rafael-at97/WMRA-UnB/README.md

# WMRA-UnB
Analysis and control of a Wheelchair Mounter Robotic Arm for a graduation thesis project in the University of Brasilia

Some code in here is supposed to be run using robopy - The python version for the Robotics Toolbox create by Peter Corke for Matlab
