rafael-at97/WMRA-UnB/hardware/CAD/Modelo3D/Note.txt

This is the model of the manipulator using the software SolidWords, the main Assembly is in the top page and sub-assemblies/parts are
organized in sub-directories.
