rafael-at97/WMRA-UnB/docs/secoes/simbolos.tex

%TCIDATA{LaTeXparent=0,0,these.tex}

%\chapter*{\setfontarial\mdseries LISTA DE SÍMBOLOS} % se usar ft1unb.sty, descomente esta linha

\chapter*{LISTA DE SÍMBOLOS}

% se usar ft2unb.sty, descomente esta linha

\subsection*{Símbolos Latinos}

\begin{tabular}{p{0.1\textwidth}p{0.63\textwidth}>{\PreserveBacklash\raggedleft}p{0.15\textwidth}}
$e$             & Força contra-eletromotriz     & {[}V{]}           \tabularnewline    
$I$             & Corrente elétrica             & {[}A{]}           \tabularnewline 
$\textbf{I}$    & Tensor de inércia             & 3x3{[}kg.m$^2${]} \tabularnewline
$\mathcal{I}$   & Momento de inércia angular    & {[}kg.m$^2${]}    \tabularnewline
$\textbf{J}$    & Matriz Jacobiana              &                   \tabularnewline
$M$             & Torque/Momento de de Força    & {[}N.m{]}         \tabularnewline
$\textbf{q}$    & Vetor das variáveis de juntas &                   \tabularnewline
$\textbf{r}$    & Vetor de posição              & 3x1{[}m{]}        \tabularnewline
$t$             & Tempo                         & {[}s{]}           \tabularnewline
$\textbf{T}$    & Matriz de transformação       &                   \tabularnewline
$v$             & Velocidade linear             & {[}m/s{]}         \tabularnewline
$\textbf{v}$    & Vetor de velocidades lineares &                   \tabularnewline
$V$             & Tensão elétrica               & {[}V{]}           \tabularnewline
$Z$             & Impedância elétrica           & {[}$\Omega${]}    \tabularnewline 
\end{tabular}

\subsection*{Símbolos Gregos}

\begin{tabular}{p{0.1\textwidth}p{0.63\textwidth}>{\PreserveBacklash\raggedleft}p{0.15\textwidth}}
$\alpha$            & Ângulo, constante                 & {[}rad{]}     \tabularnewline
$\delta$            & Variação                          &               \tabularnewline
$\theta$            & Ângulo, variável                  & {[}rad{]}     \tabularnewline
\boldmath{$\Theta$} & Vetor de ângulos                  &               \tabularnewline
$\tau$              & Constante de tempo                & {[}s{]}       \tabularnewline
$\omega$            & Velocidade angular                & {[}rad/s{]}   \tabularnewline
\boldmath{$\omega$} & Vetor de velocidades angulares    &               \tabularnewline
\boldmath{$\nu$}    & Vetor de velocidades              &               \tabularnewline
\end{tabular}

\subsection*{Grupos Adimensionais}

\begin{tabular}{p{0.1\textwidth}p{0.8\textwidth}}
i, k    &   Contador    \tabularnewline
\end{tabular}

\subsection*{Subscritos}

\begin{tabular}{p{0.1\textwidth}p{0.8\textwidth}}
$Th$    & Equivalente de Thévenin   \tabularnewline
%$ref$  & referência \tabularnewline
%$fer$  & ferramenta \tabularnewline
%$sis$  & sistema \tabularnewline
%$des$  & desejado\tabularnewline
\end{tabular}

\subsection*{Sobrescritos}

\begin{tabular}{p{0.1\textwidth}p{0.8\textwidth}}
$\hat{}$    & Vetor unitário    \tabularnewline
$\cdot$     & Variação temporal \tabularnewline
%$-$  & Valor médio \tabularnewline
\end{tabular}

\subsection*{Siglas}

\begin{tabular}{p{0.1\textwidth}p{0.8\textwidth}}
ABS     & \textit{Acrylonitrile Butadiene Styrene} - Acrilonitrila Butadieno Estireno           \tabularnewline   
AC      & \textit{Alternating Current} - Corrente Alternada                                     \tabularnewline
ADC     & \textit{Analog-to-Digital Converter} - Conversor Analógico-Digital                    \tabularnewline
ADL     & \textit{Activities of Daily Living} - Atividades Diárias Básicas                      \tabularnewline
CI      & Circuito Integrado                                                                    \tabularnewline
CMRR    & \textit{Common-Mode Rejection Ratio} - Taxa de Rejeição de Modo Comum                 \tabularnewline
CTR     & \textit{Current Transfer Ratio} - Taxa de Transmissão de Corrente                     \tabularnewline
DC      & \textit{Direct Current} - Corrente Contínua                                           \tabularnewline
DH      & Denavit-Hartenberg                                                                    \tabularnewline
LED     & \textit{Light Emitting Diode} - Diodo Emissor de Luz                                  \tabularnewline
MCU     & \textit{Microcontroller Unit} - Unidade microcontroladora                             \tabularnewline
ONU     & Organização das Nações Unidas                                                         \tabularnewline
PIC     & \textit{Peripheral Interface Controller} - Controlador de Interface Periférica        \tabularnewline
PID     & Proporcional Integral Derivativo                                                      \tabularnewline
PLA     & Poliácido láctico                                                                     \tabularnewline
PPR     & Pulsos por revolução                                                                  \tabularnewline
PVC     & \textit{Polyvinyl chloride} - Policloreto de vinila                                   \tabularnewline
PWM     & \textit{Pulse Width Modulation} - Modulação por largura de pulso                      \tabularnewline
TA      & Tecnologia Assistiva                                                                  \tabularnewline
UnB     & Universidade de Brasília                                                              \tabularnewline
WMRA    & \textit{Weelchair Mounted Robotic Arm} - Braço Robótico Montado em Cadeira de Rodas   \tabularnewline
%PCI  & \textit{Peripheral Component Interconnect}\tabularnewline
%CPU & Unidade Central de Processamento - \textit{Central Processing Unit} \tabularnewline
%AO & Saída Analógica - \textit{Analog Out}\tabularnewline
%DO & Saída Digital - \textit{Digital Out}\tabularnewline
%CS & Seletor de \textit{Chip - Chip Select}\tabularnewline
%SC & Sem Conexão\tabularnewline
%P.I. & Placa de Interface\tabularnewline
%ICW & \textit{Initialization Command Words}\tabularnewline
%OCW & \textit{Operational Control Word}\tabularnewline
\end{tabular}
