rafael-at97/WMRA-UnB/docs/revisoes/relatorio_revisoes.odt

Revisões Trabalho de Graduação

Rafael Torres – 15/0145365

- Resumo e abstract reescritos
- Símbolos alterados, negritos indicam matrizes (1xn, nx1, nxn ou nxm).
- Inserida ficha catalográfica
- Inseridos agradecimentos
- Inserida dedicatória

Introdução

- chapas de alumínio conformado → chapas de alumínio cortadas e dobradas
- primeira junta → quadril
- Termos guinada, rolagem e arfagem escritos na língua inglesa, Yaw, Pitch e roll
- punho → pulso
- “relaçãos” → reduções
- Incluída citação na tabela 1.1
- Incluídos tipos dos motores na tabela 1.1
- “de acordo” → “de modo”

Fundamentos

- Corrigidos erros de português
- “mensurar” → medir
- “driver” → circuito de acionamento
- Termos Kb e sw explicados previamente às equações
- “através” → por meio
- Termo acurácia removido, deixado apenas precisão
- Modificado texto de descrição do optoacoplador
- Sessão de controle DC aprimorada
- Descrição do modelo de posicionamento de sistemas de coordenadas modificado
- Inserido texto acerca da inversão lógica dos sinais no uso de optoacopladores.
- Jacobiana → Matriz Jacobiana

Projeto Eletro-Eletronico

- Corrigidos erros de português
- Aprimorada relação entre Ah e A.
- Evidenciado que a figura 3.1 foi construída com base em alterações dos arquivos do projeto base, e não durante o próprio projeto base.
- Indicado de onde os valores dos parâmetros foram retirados.
- Termo “similares” melhor explicado
- Fonte dos tensores de inércia e massa explicada
- Melhorada a explicação para a segunda configuração de Newton-Euler
- driver → circuito de acionamento
- Velocidade 0,0 e aceleração se mantém a mesma do trabalho base
- Inserido comentário sobre a diferença entre torques observados
- Evidenciou-se que o valor de 50mA foi retirado do datasheet do equipamento
- Compensação de baixo torque
- precisão → resolução
- Melhoria na descrição do teste do potenciômetro
- Incluída referência ao software Altium
- Incluir planos das trilhas ao lado das imagens

Projeto Controle → Comando

- Corrigidos erros de português
- Melhorada explicação dos subplanos de trabalho
- Realizado um “gancho” entre a parte que cita os testes da sub-rotina com os resultados obtidos
- Indicado que as velocidades foram obtidas através de aplicações das equações 2.16 e 2.17, cálculos intermediários dispostos no apêndice.
- Explicitado que a equação 4.12 foi utilizada para inversão simbólica
- “em 4.3” → “na figura 4.3”

Resultados

- Corrigidos erros de português
- Melhorias no texto de descrição dos resultados e valores do teste do potenciômetro
- Melhor explicado método em que cálculo da matriz foi organizado
- Definição da posição 0 do sensor com base em testes
- Análise das singularidades é realizada após a tabela 5.1. Melhor descrição dos pontos de singularidade.
- Eixos da figura 5.5 definidos.
- Explicar melhor os resultados da simulação (fig 5.5)
- Resistência mecânica explicada
- “Verificando e validando a relação” → “Verificando e validando a comunicação entre as placas”
- Incluida definição do que seria “satisfatórias”.

Conclusões

- Melhor definição do que seria “não ideal”]
- reúso → reaproveitamento de código
- definição das interrupções
- otimizado → aproveitamento

Referências

- Referências da UnB de acordo com o exposto no site da BCE.
- Expressão S.l. se refere a “sine loco”
- Utilizou-se como fonte para uniformizar as referências a norma 6023 sumarizada no documento de Alves e Arruda, como indicado no site da Mecatrônica-UnB
- Numeração das referências resolvida (inclusão da biblioteca notoccite).

Apendices e Anexos

- Apendices e anexos separados
- Inserido apêndice para definição dos sistemas de coordenadas DH
- Anexos e apêndices referenciados ao longo do texto
