rafael-at97/WMRA-UnB/docs/TG.tex

%% LyX 2.1.4 created this file.  For more info, see http://www.lyx.org/.
%% Do not edit unless you really know what you are doing.
\documentclass[a4paper,oneside,brazil,11pt,a4paper,openright,titlepage,usenames,dvipsnames]{book}
\usepackage[utf8]{inputenc}
\usepackage[T1]{fontenc}
\usepackage{lmodern}
\setcounter{secnumdepth}{3}
\setcounter{tocdepth}{3}
\usepackage{array}
\usepackage{verbatim}
\usepackage{calc}
\usepackage{textcomp}
\usepackage{amssymb}
\usepackage{graphicx}

\makeatletter

%%%%%%%%%%%%%%%%%%%%%%%%%%%%%% LyX specific LaTeX commands.
\pdfpageheight\paperheight
\pdfpagewidth\paperwidth

%% Because html converters don't know tabularnewline
\providecommand{\tabularnewline}{\\}

%%%%%%%%%%%%%%%%%%%%%%%%%%%%%% User specified LaTeX commands.
% Classe alternativa, apropriada para impressão frente-verso. Inclui páginas em branco
% de forma que capítulos sempre tenham início na página à direita:
% \documentclass[11pt,a4paper,openright,titlepage]{book}

% Pacotes
\usepackage[T1]{fontenc}
\usepackage[brazilian]{babel}
\usepackage{epsfig}
\usepackage{subfig}%\usepackage{subfigure}
\usepackage{floatrow}
\usepackage{amsfonts}
\usepackage{amsmath}
\usepackage[thmmarks,amsmath]{ntheorem}%\usepackage{amsthm}
\usepackage{boxedminipage}
\usepackage{geometry}
\usepackage{theorem}
\usepackage{fancybox}
\usepackage{fancyhdr}
\usepackage{ifthen}
\usepackage{url}
\usepackage{afterpage}
\usepackage{color}
\usepackage{colortbl}
\usepackage{rotating}
\usepackage{makeidx}
\usepackage{indentfirst}
% Pacotes para adição de figuras do inkscape
\usepackage{graphicx}
\usepackage{import}

% Escolher um dos seguintes formatos:
\usepackage{template-FT-UnB/ft2unb} % segue padrão de fontes do Latex

% Extras:
\usepackage{quoting}
\usepackage{multicol}
\usepackage{lscape}
\usepackage{notoccite}

\makeindex

\makeatother

\usepackage{babel}
\begin{document}
\setcounter{secnumdepth}{3}
\setcounter{tocdepth}{2}
\pagestyle{empty}

\grau{Engenheiro de Controle e Automação}

\tipodemonografia{TRABALHO DE GRADUAÇÃO}

\begin{comment}
Título
\end{comment}

\titulolinhai{INSTRUMENTAÇÃO E CONTROLE DE BRAÇO ROBÓTICO}

\titulolinhaii{PARA DEFICIENTES}

\titulolinhaiii{}

\titulolinhaiv{}

\begin{comment}
Autores. Basta retirar o texto totalmente caso não haja um determinado
autor.
\end{comment}

\autori{Rafael Augusto Torres}

\autorii{}

\autoriii{}

\begin{comment}
Membros da banca. Basta retirar o texto totalmente caso não haja um
determinado membro da banca.
\end{comment}

\membrodabancai{Prof. Walter de Britto Vidal Filho, ENM/UnB}

\membrodabancaifuncao{Orientador}

\membrodabancaii{Prof. Guilherme Caribé de Carvalho, ENM/UnB}

\membrodabancaiifuncao{Examinador interno}

\membrodabancaiii{Prof. José Maurício Santos Torres da Motta, ENM/UnB}

\membrodabancaiiifuncao{Examinador interno}

\membrodabancaiv{}

\membrodabancaivfuncao{}

\membrodabancav{}

\membrodabancavfuncao{}

\begin{comment}
Data de defesa: mês e ano
\end{comment}

\mes{dezembro}
\ano{2020}

\begin{comment}
Comandos para criar a capa e a página de assinaturas
\end{comment}

\capaprincipal
\capaassinaturas

\begin{comment}
Ficha Catalográfica
\end{comment}

\include{secoes/ficha_catalografica}

\begin{comment}
Dedicatória
\end{comment}

\frontmatter

\begin{comment}
Texto de dedicatória do primeiro autor.
\end{comment}

\dedicatoriaautori{Dedico este trabalho aos meus avós, que me ensinaram, 
cada um de sua maneira, a tentar ser uma pessoa melhor do que fui ontem.}

\begin{comment}
Texto de dedicatória do segundo autor. Caso não tenha um segundo autor,
este texto não será mostrado
\end{comment}

\dedicatoriaautorii{Dedicatória do autor 2}

\begin{comment}
Texto de dedicatória do terceiro autor. Caso não tenha um terceiro
autor, este texto não será mostrado
\end{comment}

\dedicatoriaautoriii{Dedicatória do autor 3}

\begin{comment}
Comando para criar a página de dedicatória
\end{comment}

\dedicatoria

\begin{comment}
Agradecimentos
\end{comment}

\begin{comment}
Texto de agradecimentos do primeiro autor.
\end{comment}

\agradecimentosautori{Agradeço inicialmente à minha tia Aline e ao meu tio Kiko, pela sua paciência e por 
me fornecerem um local em Brasília para que eu pudesse trilhar todo este caminho que me trouxe até aqui.
Agradeço eternamente à minha mãe, por sempre me deixar claro a importância da família e ao meu pai, 
que me mostrou como dar o meu melhor em tudo. À toda a minha família, deixo aqui meus agradecimentos, 
pelos diversos ensinamentos e convivência. 
Agradeço aos meus amigos, pelas conversas sinceras que me ajudaram a atravessar todos os semestres desta graduação.
Agradeço à Mecajun, por me dar a primeira oportunidade de crescimento pessoal na faculdade, e à Equipe Apuama Racing,
pela oportunidade de participar dessa equipe que me incentivou muito a aprender sobre diversas áreas.
À Equipe Droid, fica aqui meu eterno ``Obrigado!'', por ter me fornecido um ambiente de desenvolvimento pessoal, 
tanto técnico quanto nas minhas relações interpessoais, com certeza foi uma experiência marcante para mim nesta universidade. 
Obrigado ainda por ter me emprestado equipamentos de imensa importância neste trabalho :).
Por fim, agradeço à minha namorada Rosana, que teve uma paciência gigante comigo e me auxiliou a manter a calma nos dias
mais difíceis neste último passo da graduação, beijos!  
}

\begin{comment}
Texto de agradecimentos do segundo autor. Caso não tenha um segundo
autor, este texto não será mostrado.
\end{comment}

\agradecimentosautorii{A inclusão desta seção de agradecimentos é
opcional e fica à critério do(s) autor(es), que caso deseje(em) inclui-la
deverá(ão) utilizar este espaço, seguindo esta formatação.}

\begin{comment}
Texto de agradecimentos do terceiro autor. Caso não tenha um terceiro
autor, este texto não será mostrado.
\end{comment}

\agradecimentosautoriii{A inclusão desta seção de agradecimentos
é opcional e fica à critério do(s) autor(es), que caso deseje(em)
inclui-la deverá(ão) utilizar este espaço, seguindo esta formatação.}

\begin{comment}
Comando para criar a página de agradecimentos
\end{comment}

% Inicia caption das tables no topo
\floatsetup[table]{capposition=top}

\agradecimentos

\resumo{resumo}{

Este trabalho apresenta o projeto de circuitos de instrumentação e acionamento, bem como de um sistema 
central, para comando de um braço robótico montado em uma cadeira de rodas, a ser utilizado por pessoas com deficiências motoras.
O projeto de circuitos conta com a escolha de todos os dispositivos relacionados a serem inseridos na estrutura do manipulador,
visando garantir uma boa integridade dos sinais transmistidos e boa resposta de atuação.
O sistema de comando do robô foi desenvolvido de modo a utilizar uma matriz jacobina
para transformar velocidades cartesianas informadas pelo usuário através de um \textit{joystick} 
em velocidades a serem impostas nas juntas, controlando simultanemante todos os atuadores do sistema. 
Foi criado um ambiente de simulação para facilitar a visualização da posição e orientação do manipulador, que realiza
uma animação do robô na tela com base em dados obtidos pelo microcontrolador empregado.
Os sistemas foram validados através de protótipos em conjunto com o simulador.
\medskip{}

Palavras Chave: Braço Robótico Montado Sobre Cadeira de Rodas, Tecnologias Assistivas, Manipulador Robótico, Sensoriamento Robótico.

}\vspace*{2cm}

\newpage

\resumo{Abstract}{

This paper describes the design of instrumentation and driver
circuits, along with a central system, to command a wheelchair
mounted robotic arm, concerning the use by people with motor impairments.
The circuit design exposes the selection of all devices to be inserted in the manipulator structure,
in order to achieve a good signal integrity and actuation response.
The robot's command system employs a jacobian matrix to perform a transformation
between cartesian speeds informed by the user through a joystick into joint speed, controlling all the 
system's motors simultaneously.
A simulation environment was created to aid in observing the manipulator position and 
orientation, updating an animation based on data sent by the underlying microcontroller. 
The systems were verified through prototypes connected to the simulator.

\medskip{}  

Keywords: Wheelchair Mounted Robotic Arm, Assitive Technologies, Robotic Manipulator, Robot Sensing.

}

\begin{comment}
Listas de conteúdo, figuras e tabelas
\end{comment}

\sumario
\listadefiguras
\listadetabelas

\begin{comment}
Lista de Símbolos
\end{comment}

\include{secoes/simbolos}

\begin{comment}
Corpo Principal
\end{comment}

\mainmatter
\setcounter{page}{1}
\pagenumbering{arabic}
\pagestyle{plain}

%\begin{comment}
%Temp
%\end{comment}
%\include{secoes/temp}

\begin{comment}
Introdução
\end{comment}
\include{secoes/cap_Introducao}

\begin{comment}
Fundamentos
\end{comment}
\include{secoes/cap_Fundamentos}

\begin{comment}
Desenvolvimentos
\end{comment}
\include{secoes/cap_ProjetoEletroEletronico}

\begin{comment}
Continuação desenvolvimentos.
\end{comment}
\include{secoes/cap_ProjetoEletroControle}

\begin{comment}
Resultados
\end{comment}
\include{secoes/cap_Resultados}

\begin{comment}
Conclusões
\end{comment}
\include{secoes/cap_Conclusoes}

\begin{comment}
Bibliografia
\end{comment}

\renewcommand{\bibname}{REFERÊNCIAS BIBLIOGRÁFICAS}
\addcontentsline{toc}{chapter}{REFERÊNCIAS BIBLIOGRÁFICAS}

\bibliographystyle{abnt-num}
\bibliography{bibliography}

\begin{comment}
  Apêndice
\end{comment}

\begin{comment}
Anexos
\end{comment}

\apendices
\makeatletter
% não retirar estes comandos
\renewcommand{\@makechapterhead}[1]{%
  {\parindent \z@ \raggedleft \setfontarial\bfseries
\LARGE \thechapter. \space\space
\uppercase{#1}\par
\vskip 40\p@
}
}
\makeatother

\begin{comment}
  Apendice I: Modelo D-H.   
\end{comment}

\include{secoes/apendice_dh}

\refstepcounter{noApendice}

\begin{comment}
  Apendice II: Descrição do repositório.   
\end{comment}

\include{secoes/anexo_Repositorio}

\refstepcounter{noApendice}

\begin{comment}
Apendice III: Cinemática Inversa
\end{comment}

\include{secoes/anexo_Cinematica}

\refstepcounter{noApendice}

\begin{comment}
Apendice IV: Cálculos Inversão Matriz Jacobiana
\end{comment}

\include{secoes/anexo_Jacobiana}

\anexos
\makeatletter
% não retirar estes comandos
\renewcommand{\@makechapterhead}[1]{%
  {\parindent \z@ \raggedleft \setfontarial\bfseries
\LARGE \thechapter. \space\space
\uppercase{#1}\par
\vskip 40\p@
}
}
\makeatother

\begin{comment}
  Anexo I: Catalógo de Equipamentos
\end{comment}

\include{secoes/anexo_datasheets}

\refstepcounter{noAnexo}

\end{document}
