rafael-at97/WMRA-UnB/docs/adendo/secoes/cap_Conclusoes.tex

\chapter{Conclusão}

Com base na modelagem apresentada, assume-se que o modelo apresentado na figura \ref{fig:DH-Novo}
está de acordo com a convenção utilizada. Os devidos cuidados na indicação do uso dos parâmetros de
Denavit-Hartenberg em sua forma modificada foram tomados, inclusive no módulo de simulação e cálculo
dos torques nas juntas, onde através de uma variável no código define-se a versão modificada, ao invés
da versão clássica padrão.
