rafael-at97/WMRA-UnB/docs/adendo/secoes/cap_Fundamentos.tex

\chapter{Fundamentação Teórica}

\label{sec:fundamentos}

Como informado no texto original, foi adotada a convenção exposta em \cite{craig2009introduction}, tanto
para o posicionamento dos sistemas de referência quanto para definição dos parâmetros de Denavit-Hartenberg.
É importante notar que o livro utilizado como base para o trabalho emprega a forma modificada destes 
parâmetros, com a seguinte definição para cada termo:

\begin{itemize}
    \begin{centering}
    \item[] $a_i$ = distância entre $\hat{Z}_i$ e $\hat{Z}_{i+1}$, ao longo de $\hat{X}_i$;
    \item[] $\alpha_i$ = ângulo entre $\hat{Z}_i$ e $\hat{Z}_{i+1}$, em relação a $\hat{X}_i$;
    \item[] $d_i$ = distância entre $\hat{X}_{i-1}$ e $\hat{X}_i$, ao longo de $\hat{Z}_i$;
    \item[] $\theta_i$ = ângulo entre $\hat{X}_{i-1}$ e $\hat{X}_i$, em relação a $\hat{Z}_i$.
    \par\end{centering}
\end{itemize}

A versão modificada definida pelo autor em \cite{craig2009introduction} diferencia-se da versão 
clássica utilizada por outros autores, como Paul \cite{paul1981robot} e Spong \cite{spong2008robot}.
A relação entre estas versões pode ser vista em \cite{reddy2014difference}, que expõe as diferenças nas
convenções bem como exemplos de aplicação para alguns manipuladores.

A convenção utilizada no trabalho base, e portanto no trabalho de graduação, é simplificada com 
base nos seguintes passos \cite{craig2009introduction}:

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
