rafael-at97/WMRA-UnB/docs/adendo/adendo-dh.pdf

No uso de parâmetros Denavit-Hartenberg para descrever manipuladores robóticos, bem como para posicionar os sistemas de referência em relação a sua estrutura, existem duas convenções vigentes na literatura. Embora as notações sejam semelhantes, representando uma junta como duas translações, a e d, e duas rotações α e θ, as matrizes de transformação apresentam diferenças [1]. Para a versão clássica, utilizada por Spong [2], αi e ai são definidos com base no eixo Xˆ da junta i, já os parâmetros di e θi são definidos com base no eixo Zˆ da junta i − 1, assim como

mostra a figura 1.

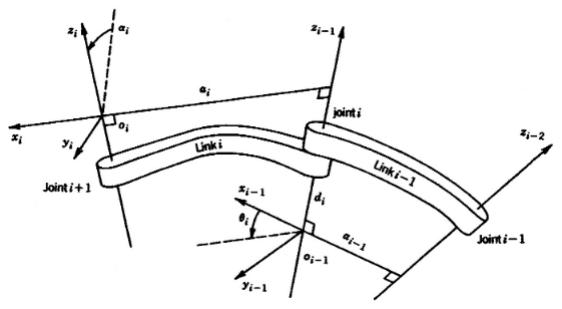
[picture p54: figure]

Figura 1: Arranjo clássico [2].

Já no modelo modificado, utilizado por Craig [3], utilizam-se os parâmetros αi−1 e ai−1, definidos em função do eixo Xˆ
i−1, e os parâmetros di e θi

, definidos em função de Zˆ
i

, assim como
mostra a figura 2.


Figura 2: Arranjo modificado [3].

Utilizando a definição para o termo di exposta no trabalho [3] (di significa a distância entre

Xˆ

i−1 e Xˆ
i

, ao longo de Zˆ
i), nota-se na figura do trabalho de graduação, 3, que o parâmetro d6 está ao longo do eixo Zˆ

6, seguindo a convenção proposta por Craig. O eixo Zˆ
6, devido à construção do
manipulador, coincidirá sempre com o eixo Yˆ
5 para a convenção adotada. De acordo com a figura 2, o parâmetro foi definido entre a origem do sistema da junta i, com i = 6, e a intersecção entre Zˆ

i (Zˆ

6) e Xˆ

i−1 (Xˆ
5), que coincide com a origem do sistema {5}.

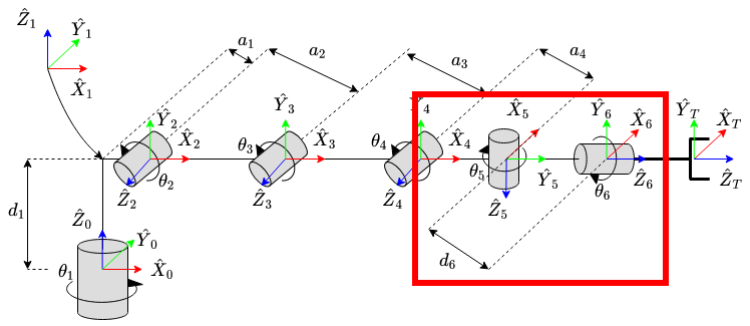
[picture p55: figure]

Figura 3: Arranjo proposto.

# REFERÊNCIAS BIBLIOGRÁFICAS

[1] REDDY, A. C. Difference between denavit-hartenberg (d-h) classical and modified conventions

for forward kinematics of robots with case study. In: International Conference on Advanced Materials and manufacturing Technologies (AMMT), 2014, India. [S.l.: s.n.], 2014.

[2] SPONG, M. W.; VIDYASAGAR, M. Robot dynamics and control. 1st. ed. New York: John

Wiley & Sons, 1989.

[3] CRAIG, J. J. Introduction to robotics: mechanics and control. 3rd. ed. [S.l.]: Pearson Education

India, 2009.
