rafael-at97/WMRA-UnB/docs/images/arm/joint1-mass.jpg

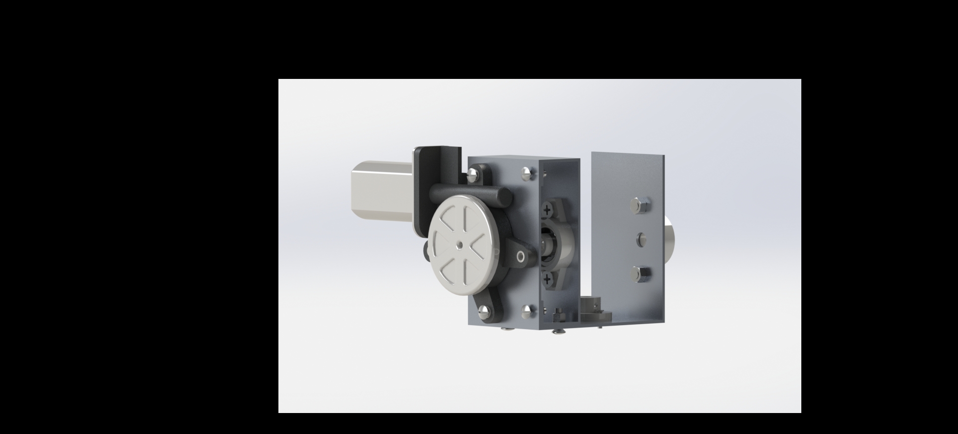
docs/images/arm/joint1-mass.jpg
