rafael-at97/WMRA-UnB/docs/images/arm/joint2-mass.jpg

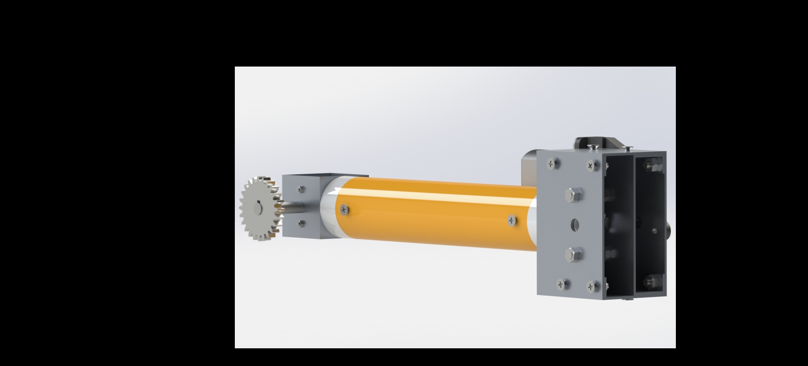
docs/images/arm/joint2-mass.jpg
