rafael-at97/WMRA-UnB/docs/images/arm/joint3-mass.jpg

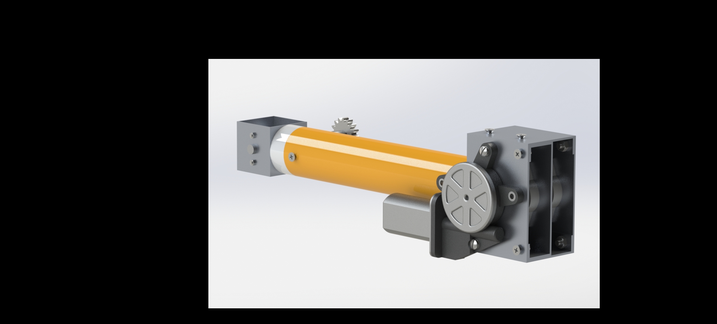
docs/images/arm/joint3-mass.jpg
