rafael-at97/WMRA-UnB/docs/images/arm/joint4-mass.jpg

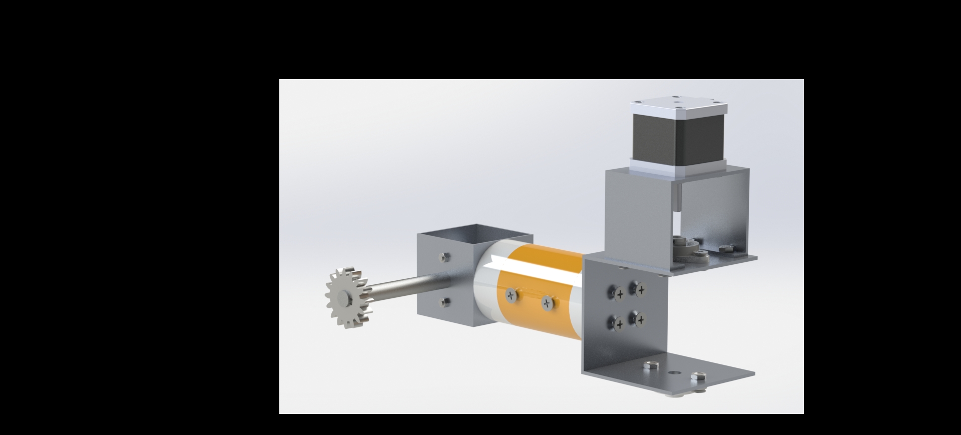
docs/images/arm/joint4-mass.jpg
