rafael-at97/WMRA-UnB/docs/images/arm/joint5-mass.jpg

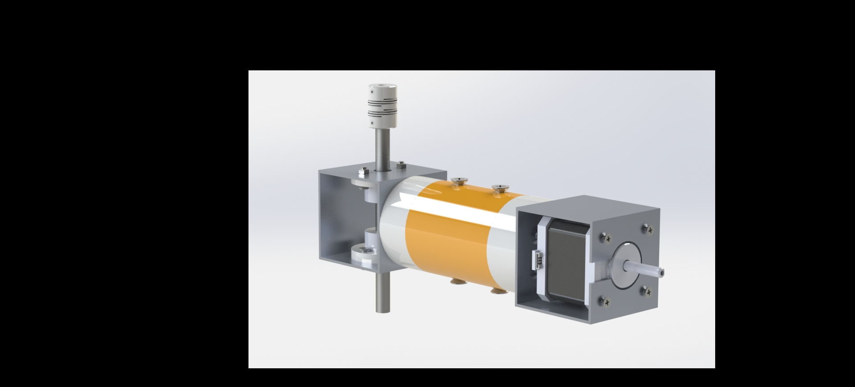
docs/images/arm/joint5-mass.jpg
