rafael-at97/WMRA-UnB/docs/images/arm/spring.jpg

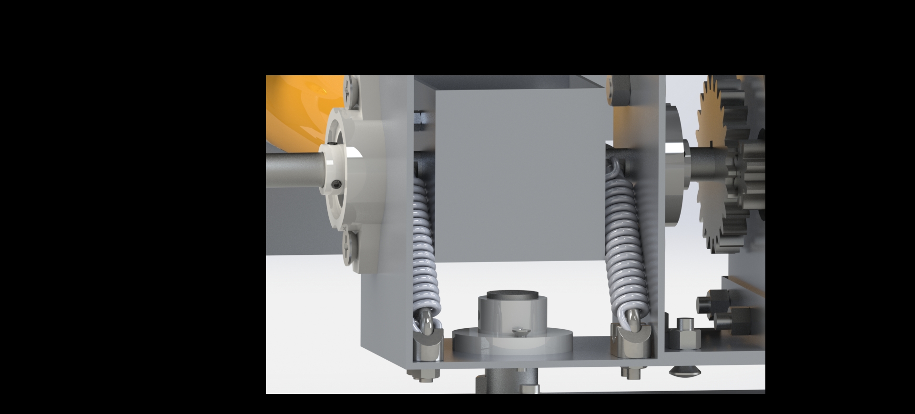
docs/images/arm/spring.jpg
