rafael-at97/WMRA-UnB/docs/images/pcbs/MainPCB-SizeConstraints.png

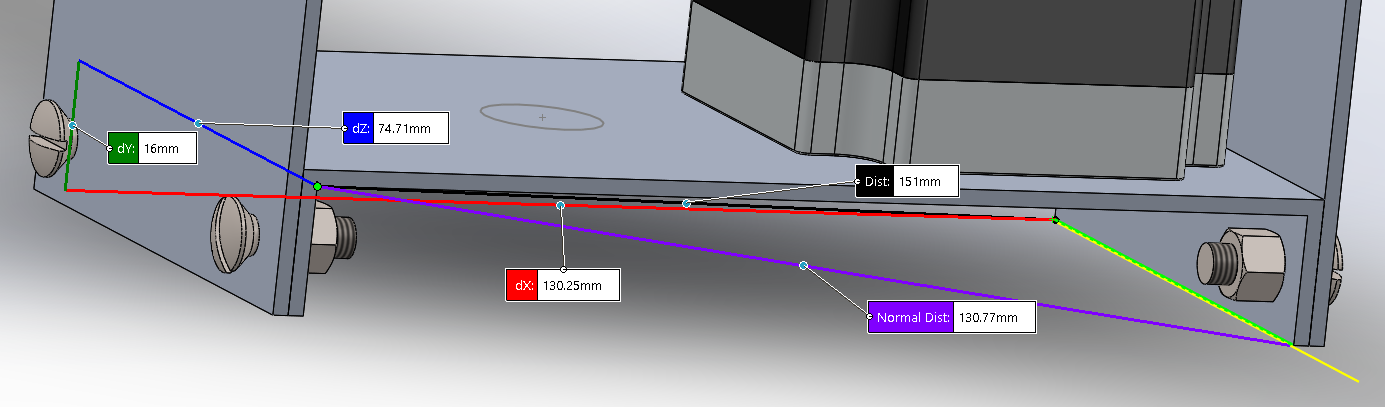
docs/images/pcbs/MainPCB-SizeConstraints.png
