rafael-at97/WMRA-UnB/hardware/CAD/Imagens/RefFrames_SideView.png

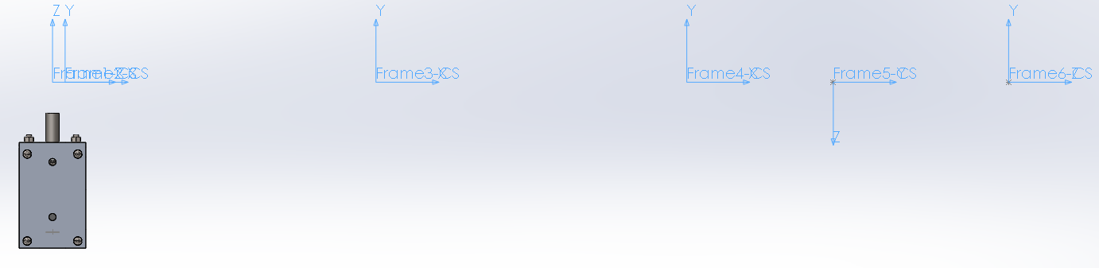
hardware/CAD/Imagens/RefFrames_SideView.png
