rafael-at97/WMRA-UnB/hardware/CAD/Imagens/RefFrames_TopView.png

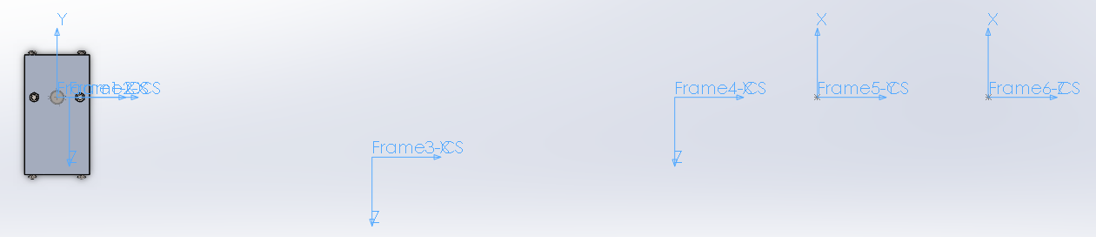
hardware/CAD/Imagens/RefFrames_TopView.png
