rafael-at97/WMRA-UnB/hardware/CAD/Imagens/RefFrames_View.png

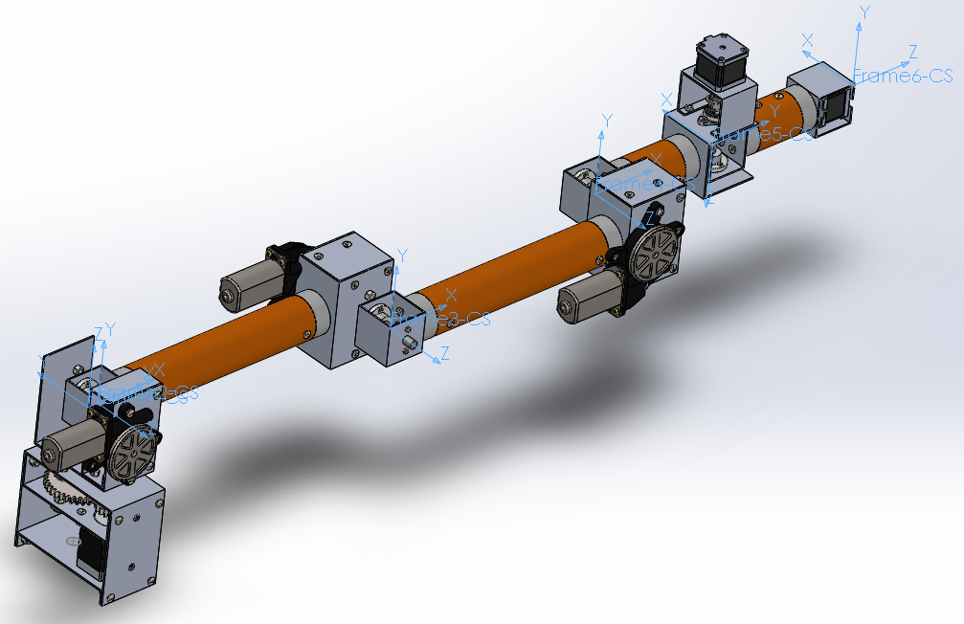
hardware/CAD/Imagens/RefFrames_View.png
