rafael-at97/WMRA-UnB/hardware/CAD/Modelo3D/Assembly Geral.SLDASM

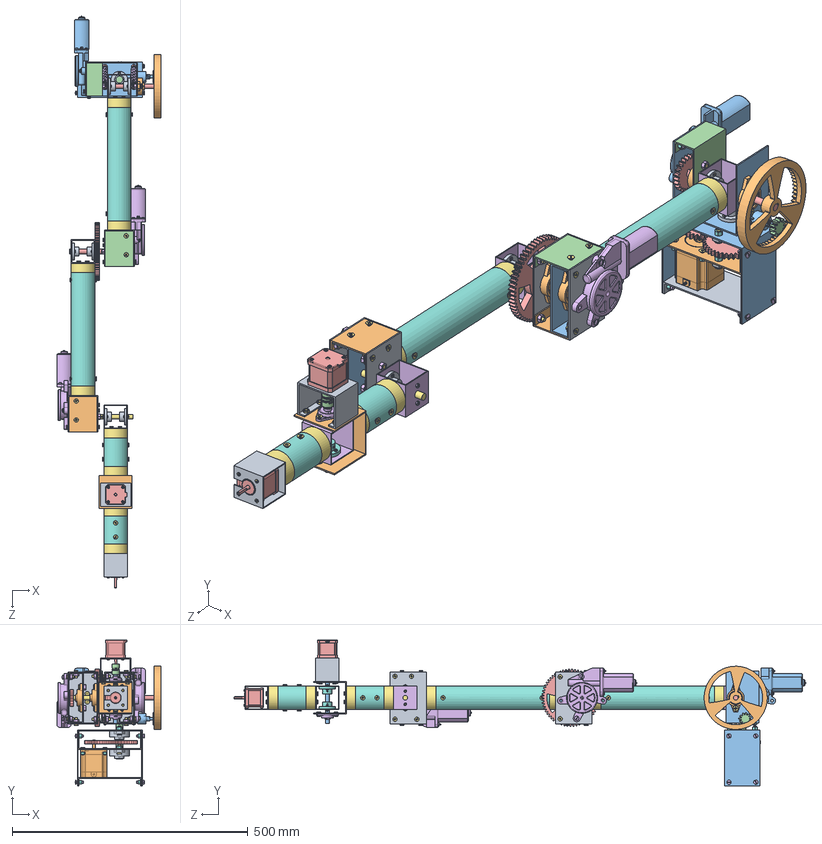
[picture p73: CAD file, 2020-11-12]
hardware/CAD/Modelo3D/Assembly Geral.SLDASM
221.0 x 309.4 x 1211.2 mm
Junta 0 parte 1
Junta 0 parte 2
Junta 0 parte 3
Eixo 0
spur gear_iso x 5
countersunk slotted raised head screw_iso x 18
countersunk flat head cross recess screw_iso x 122
hex nut gradec_iso x 22
Rolamento KFL002 Ø15 x 2
NEMA23
Junta 1 parte 1
Junta 1 parte 2
Eixo 1
hex nut style 1 gradeab_iso x 52
Parafuso-mola x 3
hex nut style 1_am x 9
Bucha 10 mm x 7
Rolamento KFL000 Ø10 x 6
Motor Mabuchi LE
Presilha x 2
PresilhaHousing x 2
Caixa Aluminio 1 x 4
Conector Nylon x 8
Conector PVC 1-2 x 2
Junta 2-3 parte 1 x 2
Junta 2-3 parte 2 x 2
Junta 2-3 parte 3 x 2
Junta 2-3 parte 4 x 2
Eixo 2
Motor Mabuchi LD x 2
Eixo 3
Conector PVC 3-4 x 2
Junta 4 parte 1
Junta 4 parte 2
Eixo 4
Acoplamento Flexível MSTS-16-5-8
NEMA17 x 2
Rolamento KFL08 Ø8 x 2
hex nut jam_am x 8
Bucha 8 mm x 2
Junta 5
Mola-tracao x 2
