rafael-at97/WMRA-UnB/hardware/CAD/Modelo3D/Elos/Caixa Alumínio.SLDASM

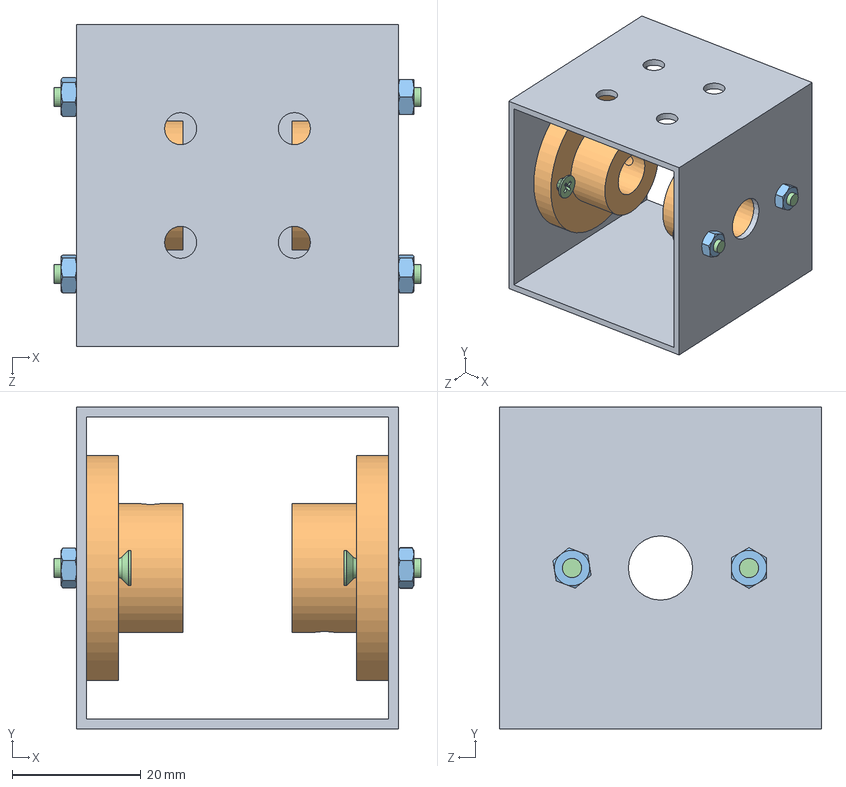
[picture p74: CAD file, 2020-04-07]
hardware/CAD/Modelo3D/Elos/Caixa Alumínio.SLDASM
57.0 x 50.0 x 50.0 mm
Caixa Aluminio 1
Bucha 10 mm x 2
hex nut style 1 gradeab_iso x 4
countersunk flat head cross recess screw_iso x 4
