rafael-at97/WMRA-UnB/hardware/CAD/Modelo3D/Elos/Elo 1-2/Elo1-2-Assembly.SLDASM

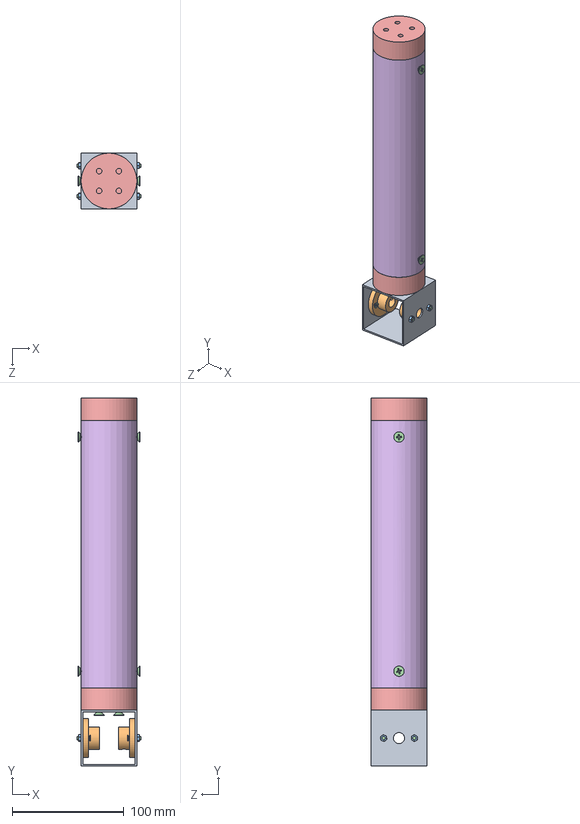
[picture p75: CAD file, 2020-04-07]
hardware/CAD/Modelo3D/Elos/Elo 1-2/Elo1-2-Assembly.SLDASM
57.0 x 330.0 x 50.0 mm
Caixa Aluminio 1
Bucha 10 mm x 2
hex nut style 1 gradeab_iso x 4
countersunk flat head cross recess screw_iso x 12
Conector Nylon x 2
Conector PVC 1-2
