rafael-at97/WMRA-UnB/hardware/CAD/Modelo3D/Junta 2-3/Junta2-3-Assembly.SLDASM

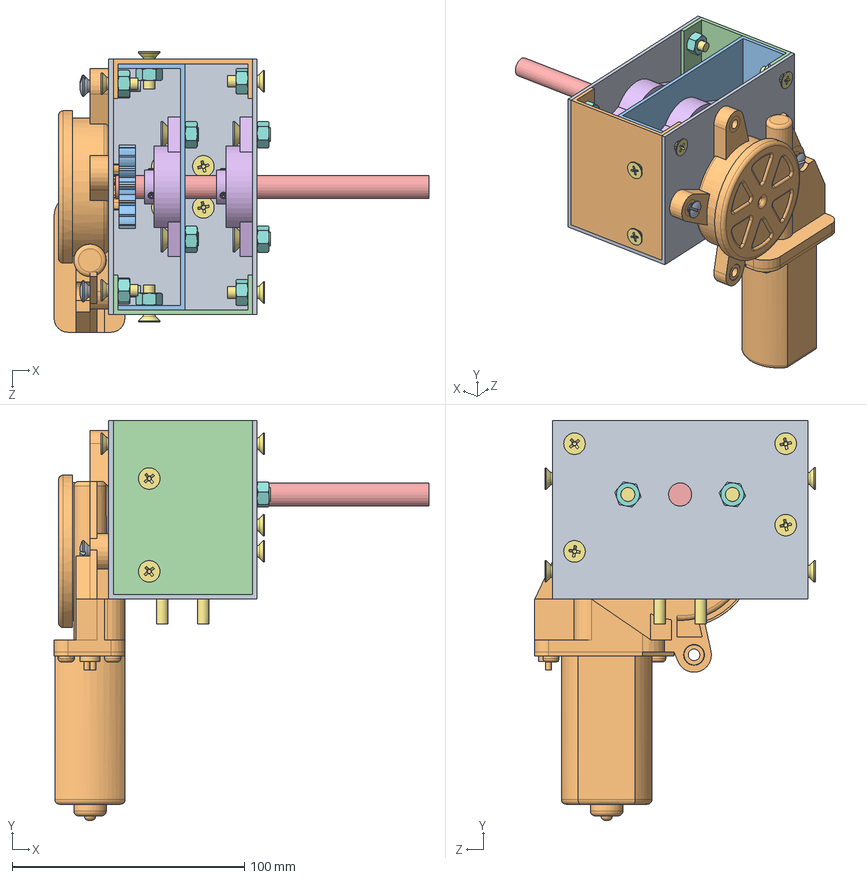
[picture p76: CAD file, 2020-04-07]
hardware/CAD/Modelo3D/Junta 2-3/Junta2-3-Assembly.SLDASM
161.5 x 172.3 x 120.9 mm
Junta 2-3 parte 1
Junta 2-3 parte 2
Junta 2-3 parte 3
Junta 2-3 parte 4
Eixo 2-3
Rolamento KFL000 Ø10 x 2
countersunk flat head cross recess screw_iso x 18
hex nut style 1 gradeab_iso x 16
countersunk slotted raised head screw_iso x 2
Motor Mabuchi LD
spur gear_iso
