rafael-at97/WMRA-UnB/hardware/CAD/Modelo3D/Junta 5/Junta5-Assembly.SLDASM

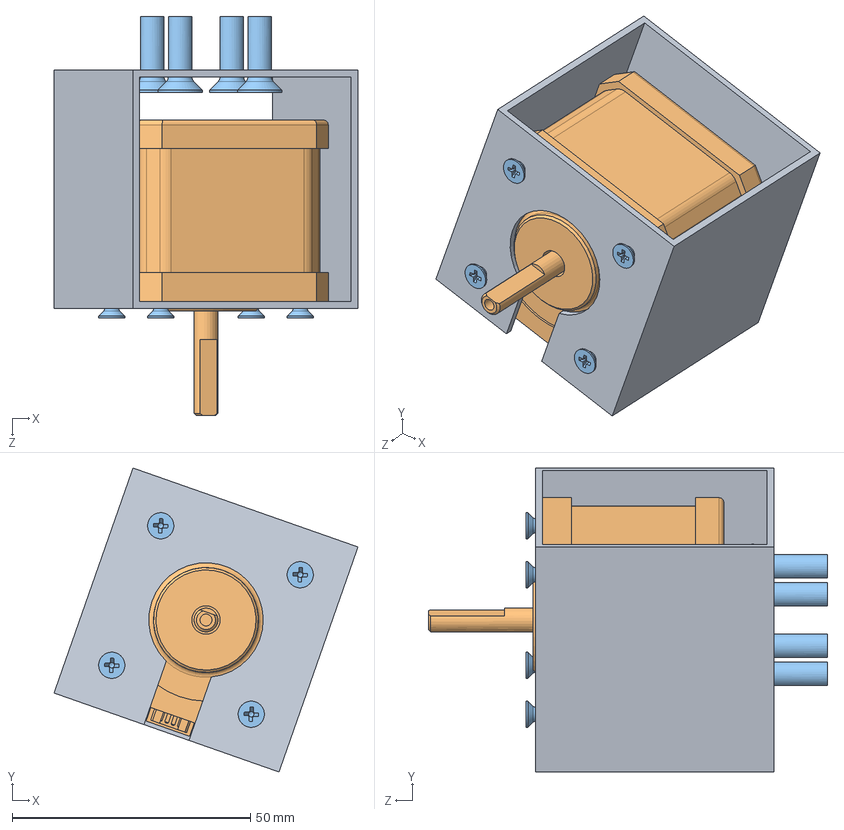
[picture p77: CAD file, 2020-04-07]
hardware/CAD/Modelo3D/Junta 5/Junta5-Assembly.SLDASM
63.7 x 63.7 x 83.8 mm
Junta 5
NEMA17
countersunk flat head cross recess screw_iso x 8
