rafael-at97/WMRA-UnB/hardware/CAD/Modelo3D/Elos/Elo 3-4/Elo4-Assembly.SLDASM

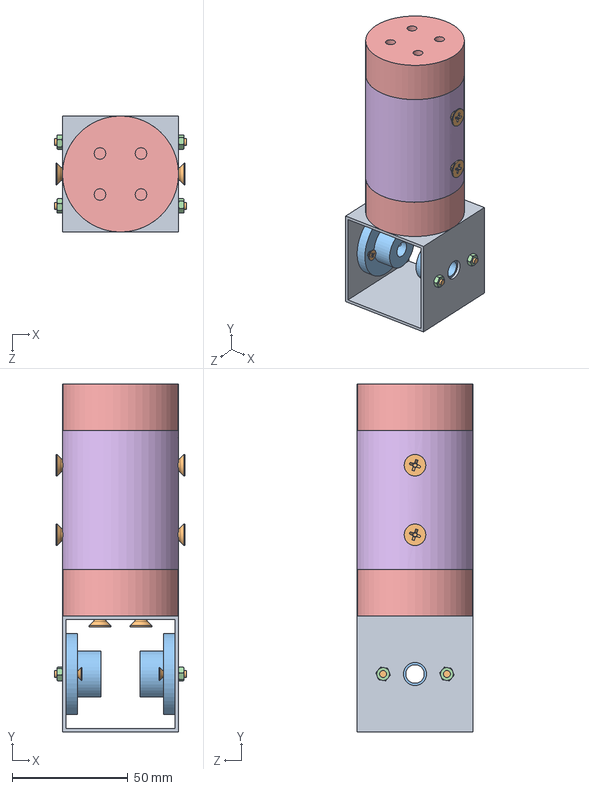
[picture p78: CAD file, 2020-04-07]
hardware/CAD/Modelo3D/Elos/Elo 3-4/Elo4-Assembly.SLDASM
57.0 x 150.0 x 50.0 mm
Caixa Aluminio 1
countersunk flat head cross recess screw_iso x 12
Bucha 8 mm x 2
hex nut style 1 gradeab_iso x 4
Conector Nylon x 2
Conector PVC 3-4
