rafael-at97/WMRA-UnB/hardware/CAD/Modelo3D/Acoplamentos/Presilha Tipo-U/Presilha-Assembly.SLDASM

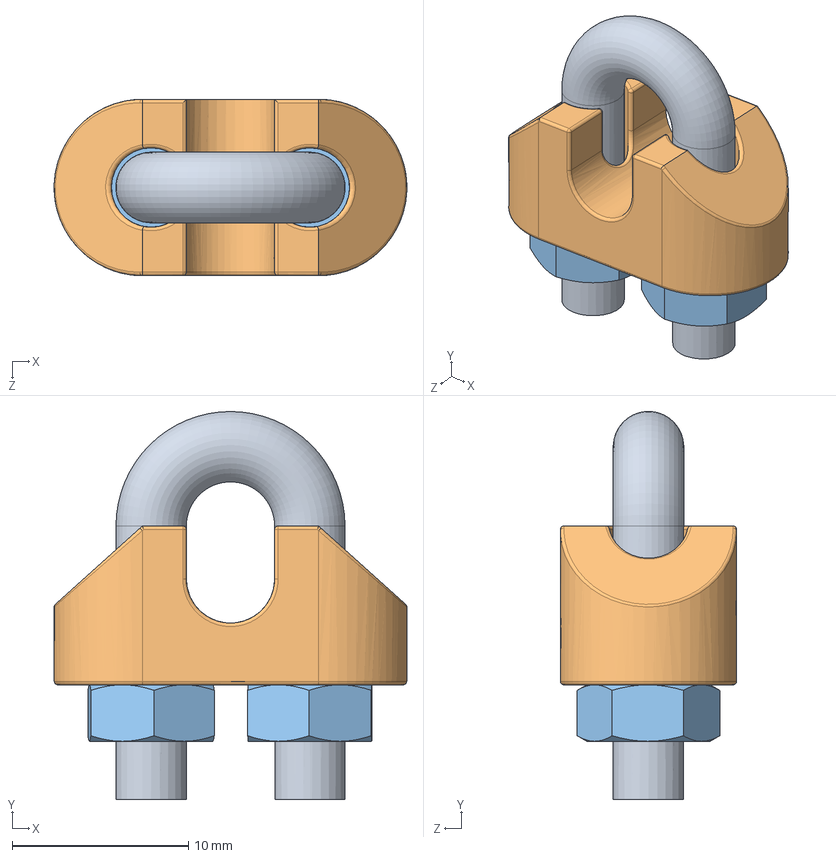
[picture p79: CAD file, 2020-11-12]
hardware/CAD/Modelo3D/Acoplamentos/Presilha Tipo-U/Presilha-Assembly.SLDASM
20.0 x 22.0 x 10.0 mm
Presilha
PresilhaHousing
hex nut style 1_am x 2
