rafael-at97/WMRA-UnB/hardware/CAD/Modelo3D/Elos/Caixa Alumínio 2.SLDASM

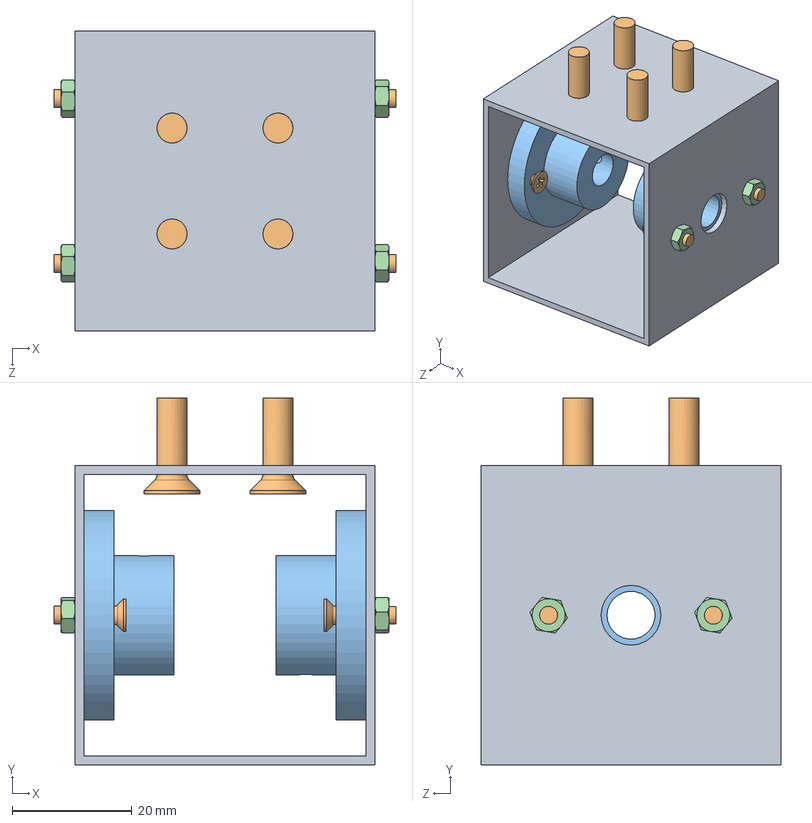
[picture p80: CAD file, 2020-04-07]
hardware/CAD/Modelo3D/Elos/Caixa Alumínio 2.SLDASM
57.0 x 61.3 x 50.0 mm
Caixa Aluminio 1
countersunk flat head cross recess screw_iso x 8
Bucha 8 mm x 2
hex nut style 1 gradeab_iso x 4
