rafael-at97/WMRA-UnB/hardware/CAD/Modelo3D/Junta 1/Junta1-Assembly.SLDASM

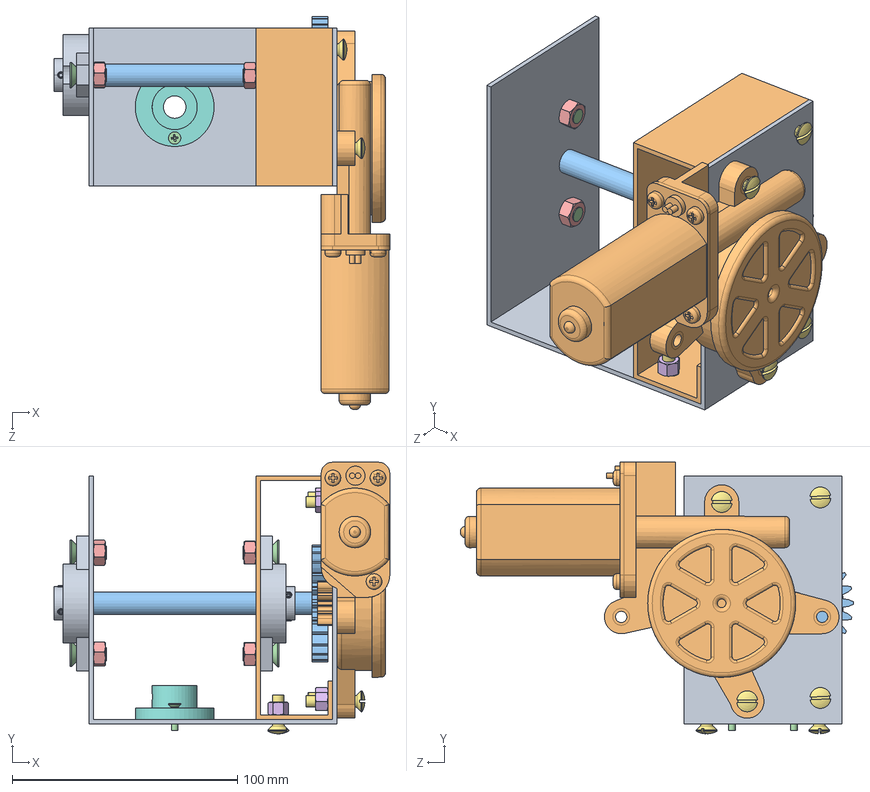
[picture p81: CAD file, 2020-04-07]
hardware/CAD/Modelo3D/Junta 1/Junta1-Assembly.SLDASM
149.0 x 120.6 x 174.4 mm
Junta 1 parte 1
Junta 1 parte 2
Eixo 1
countersunk flat head cross recess screw_iso x 6
hex nut style 1 gradeab_iso x 4
hex nut gradec_iso x 6
countersunk slotted raised head screw_iso x 6
Bucha 10 mm
Rolamento KFL000 Ø10 x 2
Motor Mabuchi LE
spur gear_iso
