rafael-at97/WMRA-UnB/hardware/CAD/Modelo3D/Junta 4/Junta4-Assembly.SLDASM

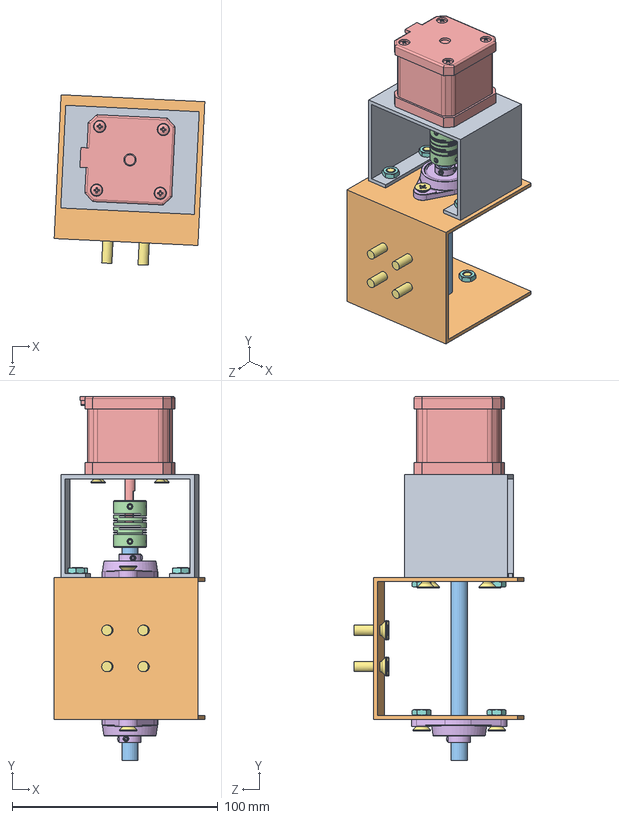
[picture p82: CAD file, 2020-04-07]
hardware/CAD/Modelo3D/Junta 4/Junta4-Assembly.SLDASM
73.3 x 177.0 x 82.9 mm
Junta 4 parte 1
Junta 4 parte 2
Eixo 4
Acoplamento Flexível MSTS-16-5-8
NEMA17
Rolamento KFL08 Ø8 x 2
countersunk flat head cross recess screw_iso x 16
hex nut jam_am x 8
