rafael-at97/WMRA-UnB/hardware/CAD/Modelo3D/Junta 0/Junta0-Assembly.SLDASM

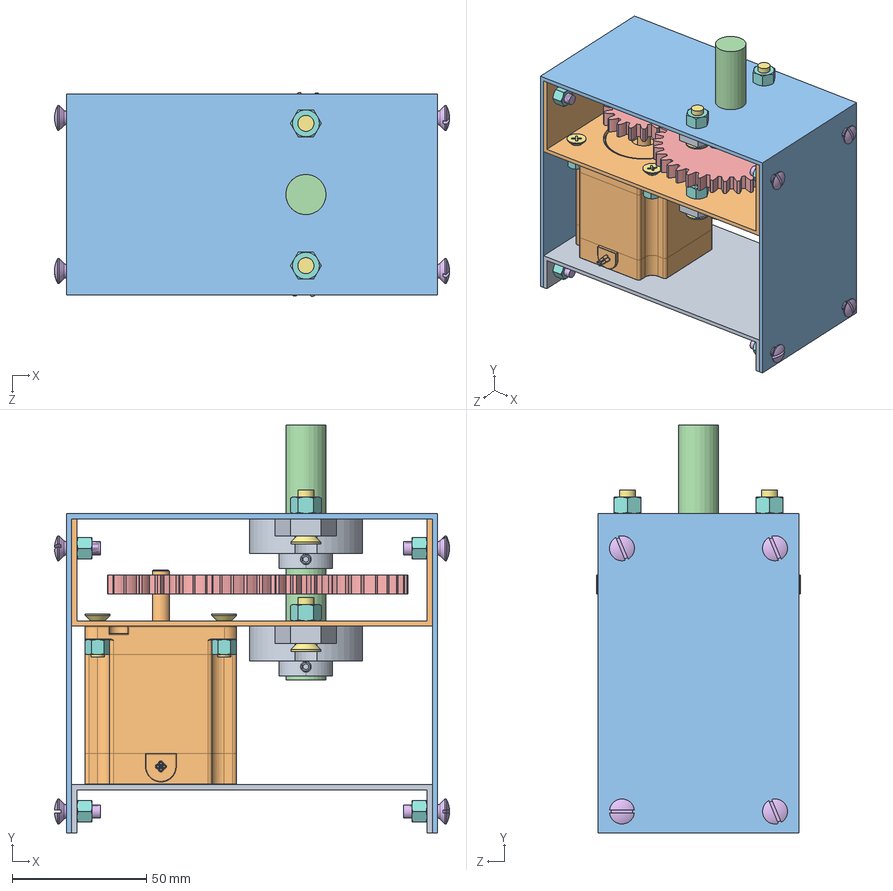
[picture p83: CAD file, 2020-04-07]
hardware/CAD/Modelo3D/Junta 0/Junta0-Assembly.SLDASM
147.1 x 151.9 x 75.9 mm
Junta 0 parte 1
Junta 0 parte 2
Junta 0 parte 3
Eixo 0
spur gear_iso x 2
countersunk slotted raised head screw_iso x 8
countersunk flat head cross recess screw_iso x 8
hex nut gradec_iso x 16
Rolamento KFL002 Ø15 x 2
NEMA23
