rafael-at97/WMRA-UnB/hardware/CAD/Modelo3D/Acoplamentos/Acoplamento Flexível MSTS-16-5-8.SLDPRT

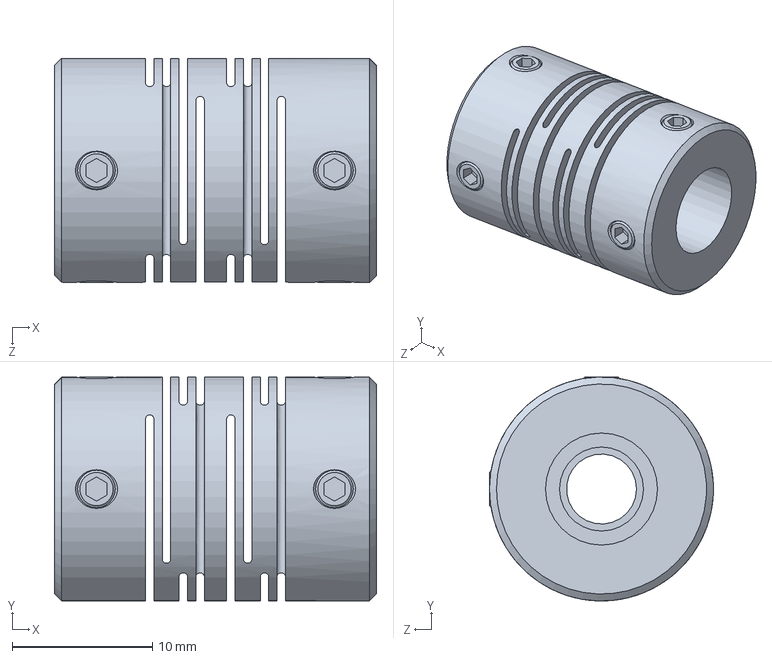
[picture p84: CAD file, 2020-04-07]
hardware/CAD/Modelo3D/Acoplamentos/Acoplamento Flexível MSTS-16-5-8.SLDPRT
23.0 x 16.0 x 16.0 mm
