rafael-at97/WMRA-UnB/hardware/CAD/Modelo3D/Acoplamentos/Presilha Tipo-U/PresilhaHousing.SLDPRT

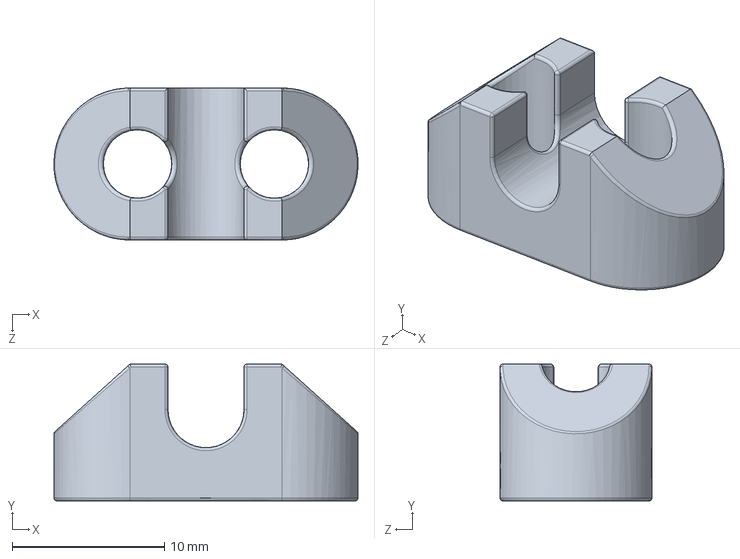
[picture p85: CAD file, 2020-11-12]
hardware/CAD/Modelo3D/Acoplamentos/Presilha Tipo-U/PresilhaHousing.SLDPRT
20.0 x 9.00 x 10.0 mm
