rafael-at97/WMRA-UnB/hardware/CAD/Modelo3D/Buchas/Bucha 8 mm.SLDPRT

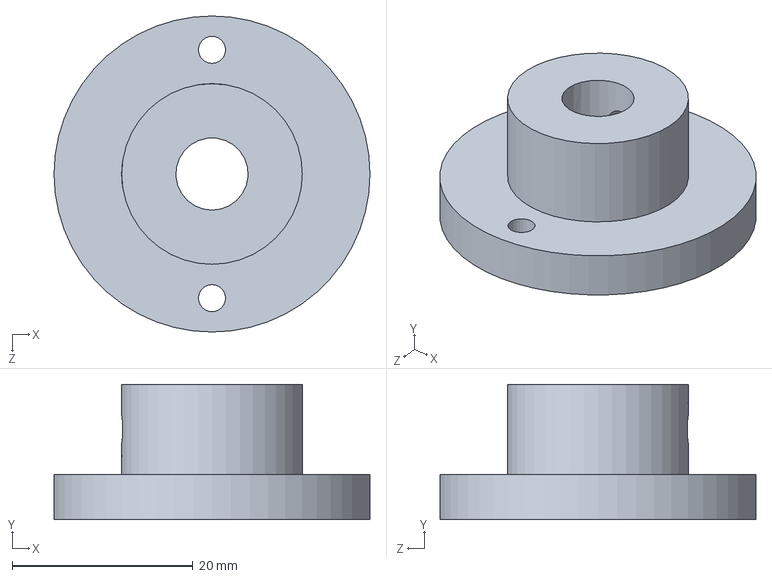
[picture p86: CAD file, 2020-04-07]
hardware/CAD/Modelo3D/Buchas/Bucha 8 mm.SLDPRT
35.0 x 15.0 x 35.0 mm
