rafael-at97/WMRA-UnB/hardware/CAD/Modelo3D/Elos/Elo 3-4/Conector PVC 3-4.SLDPRT

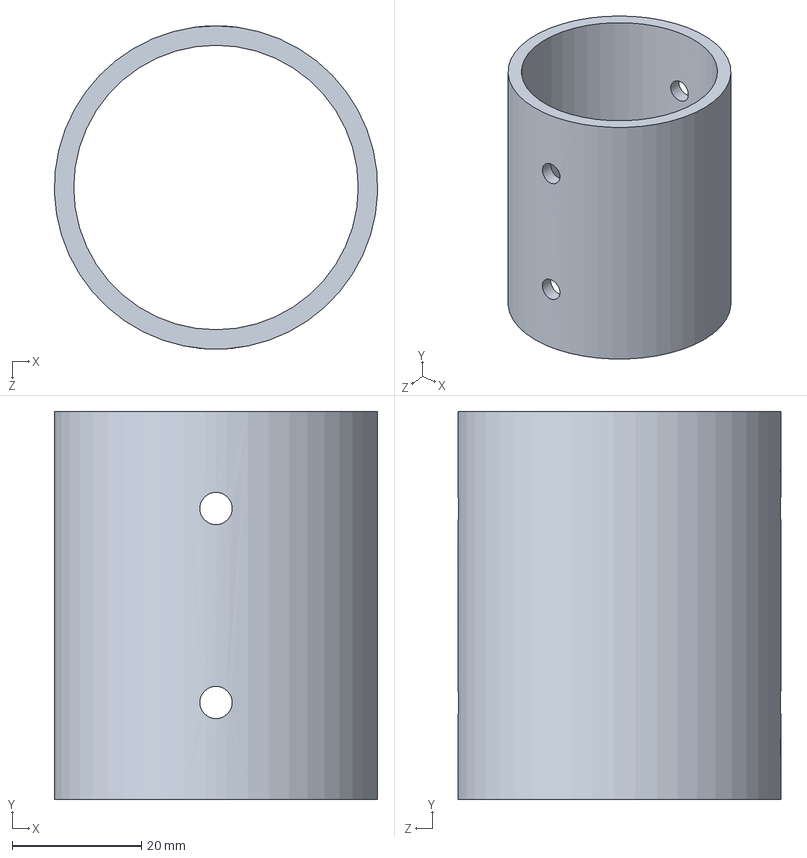
[picture p87: CAD file, 2020-04-07]
hardware/CAD/Modelo3D/Elos/Elo 3-4/Conector PVC 3-4.SLDPRT
50.0 x 60.0 x 50.0 mm
