rafael-at97/WMRA-UnB/hardware/CAD/Modelo3D/Junta 1/Junta 1 parte 2.SLDPRT

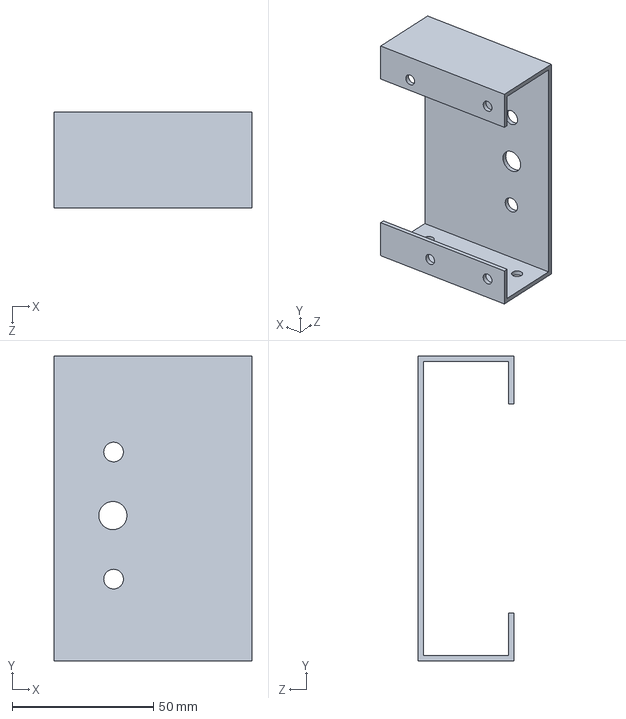
[picture p89: CAD file, 2020-04-07]
hardware/CAD/Modelo3D/Junta 1/Junta 1 parte 2.SLDPRT
70.0 x 108.0 x 34.0 mm
