rafael-at97/WMRA-UnB/hardware/CAD/Modelo3D/Junta 4/Eixo 4.SLDPRT

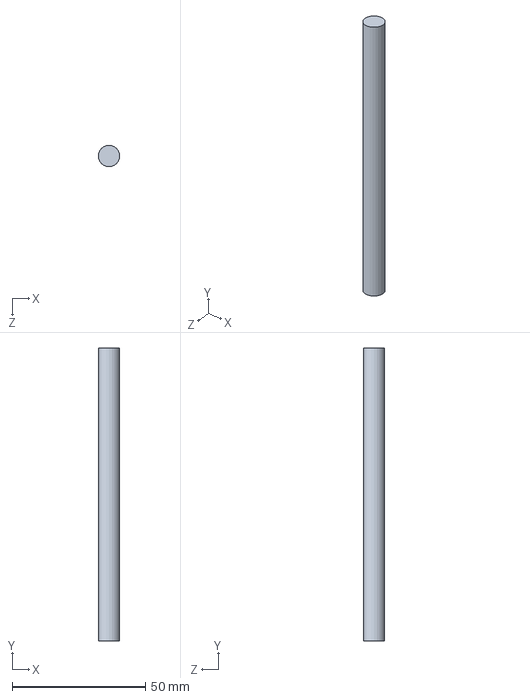
[picture p90: CAD file, 2020-04-07]
hardware/CAD/Modelo3D/Junta 4/Eixo 4.SLDPRT
8.00 x 110.0 x 8.00 mm
