rafael-at97/WMRA-UnB/hardware/CAD/Modelo3D/Molas/Mola-tracao.SLDPRT

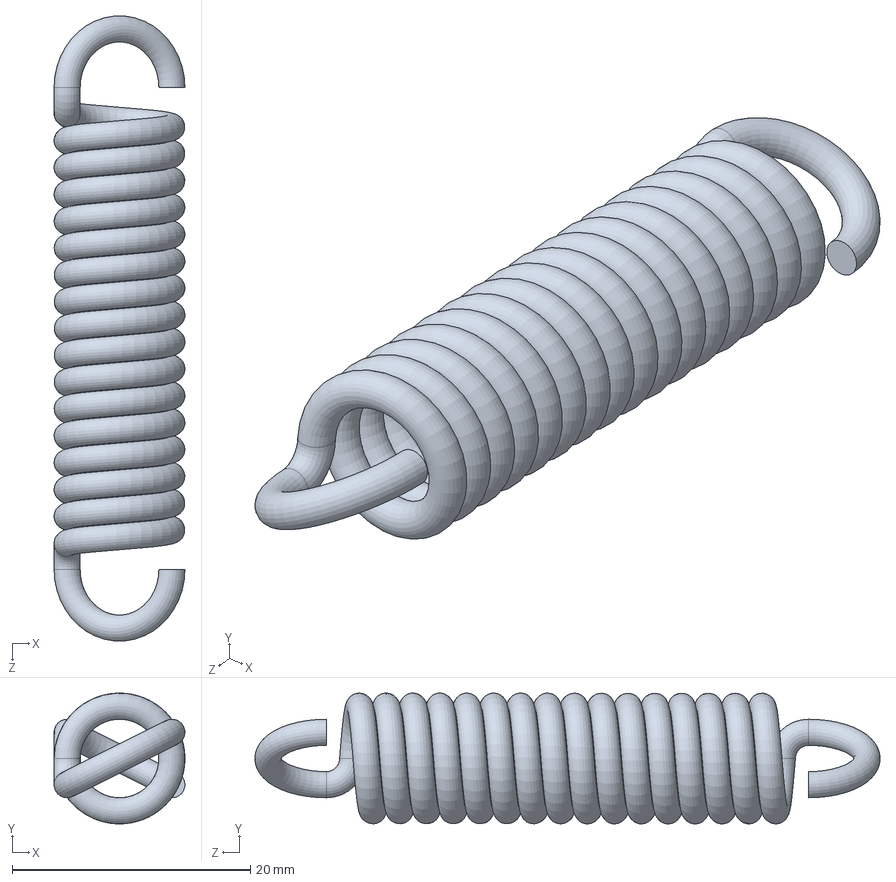
[picture p91: CAD file, 2020-11-12]
hardware/CAD/Modelo3D/Molas/Mola-tracao.SLDPRT
11.0 x 11.0 x 52.5 mm
