rafael-at97/WMRA-UnB/hardware/CAD/Modelo3D/Motores/Motor Mabuchi LE.SLDPRT

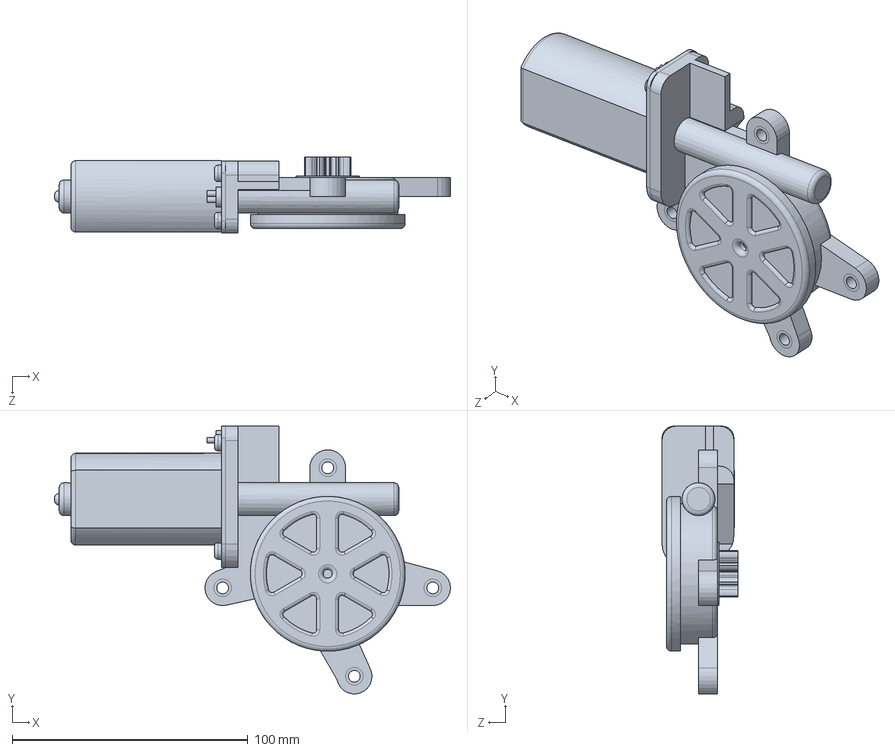
[picture p92: CAD file, 2020-04-07]
hardware/CAD/Modelo3D/Motores/Motor Mabuchi LE.SLDPRT
168.1 x 113.6 x 32.2 mm
