rafael-at97/WMRA-UnB/hardware/CAD/Modelo3D/Parafusos e Porcas/Parafuso-mola.SLDPRT

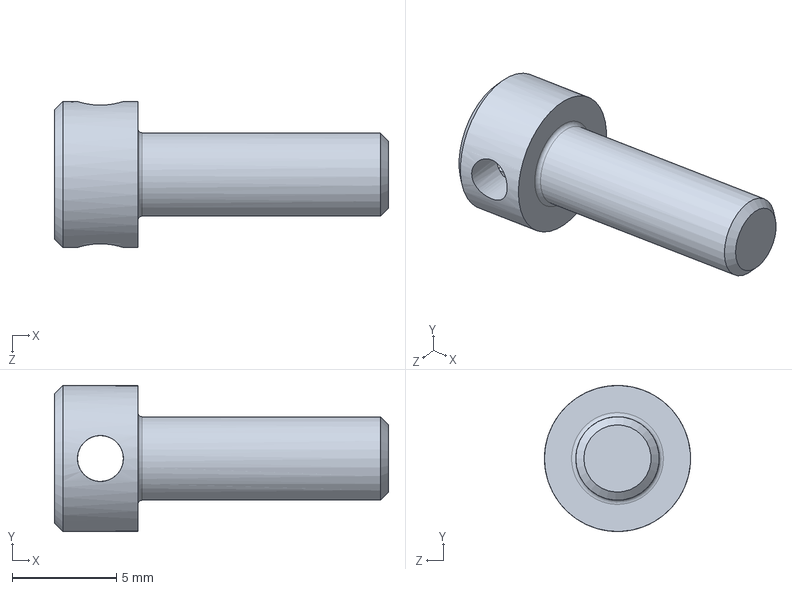
[picture p93: CAD file, 2020-11-12]
hardware/CAD/Modelo3D/Parafusos e Porcas/Parafuso-mola.SLDPRT
16.0 x 6.99 x 7.00 mm
