rafael-at97/WMRA-UnB/hardware/CAD/Modelo3D/Rolamentos/Rolamento KFL08 Ø8.SLDPRT

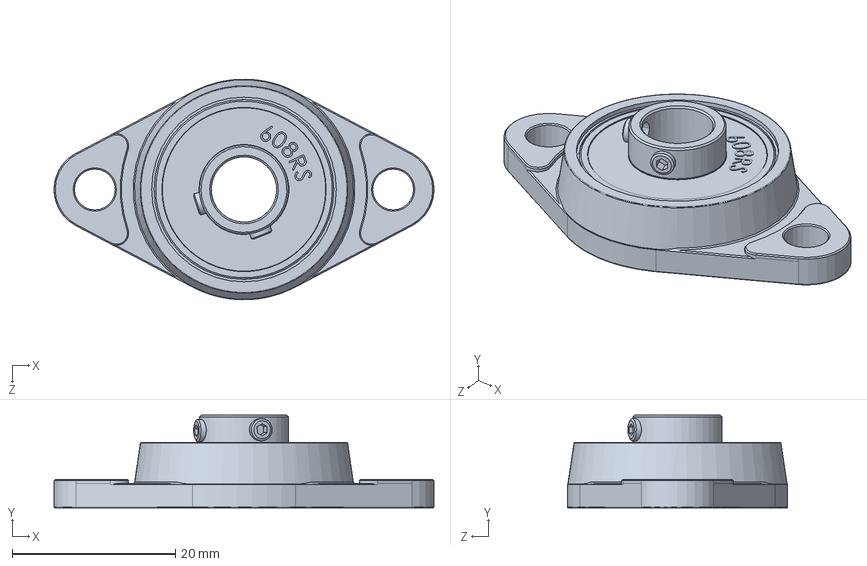
[picture p94: CAD file, 2020-04-07]
hardware/CAD/Modelo3D/Rolamentos/Rolamento KFL08 Ø8.SLDPRT
46.5 x 11.4 x 27.0 mm
