rafael-at97/WMRA-UnB/hardware/CAD/Modelo3D/Sensores/Potentiometer-Knob.SLDPRT

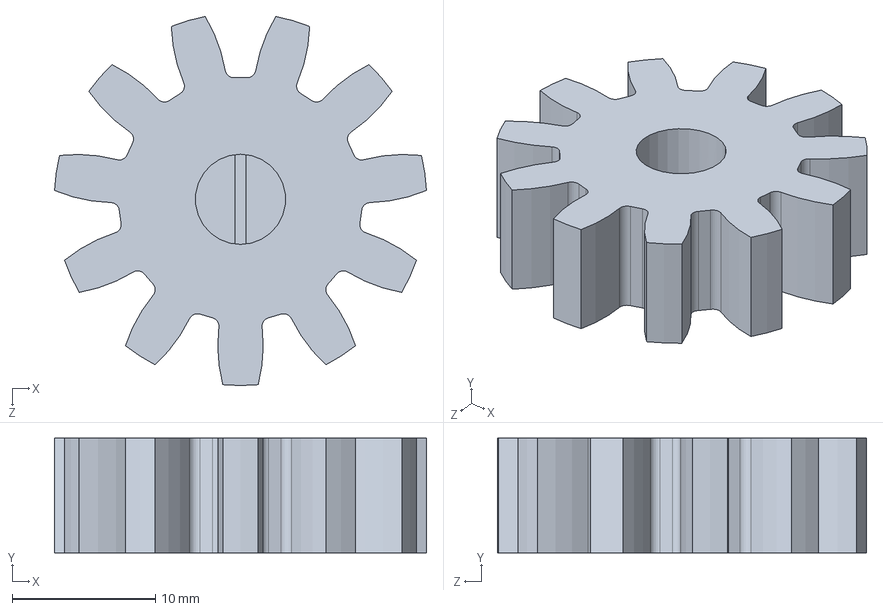
[picture p95: CAD file, 2020-11-12]
hardware/CAD/Modelo3D/Sensores/Potentiometer-Knob.SLDPRT
26.0 x 8.00 x 25.8 mm
