rafael-at97/WMRA-UnB/hardware/CAD/Modelo3D/Acoplamentos/Presilha Tipo-U/Presilha.SLDPRT

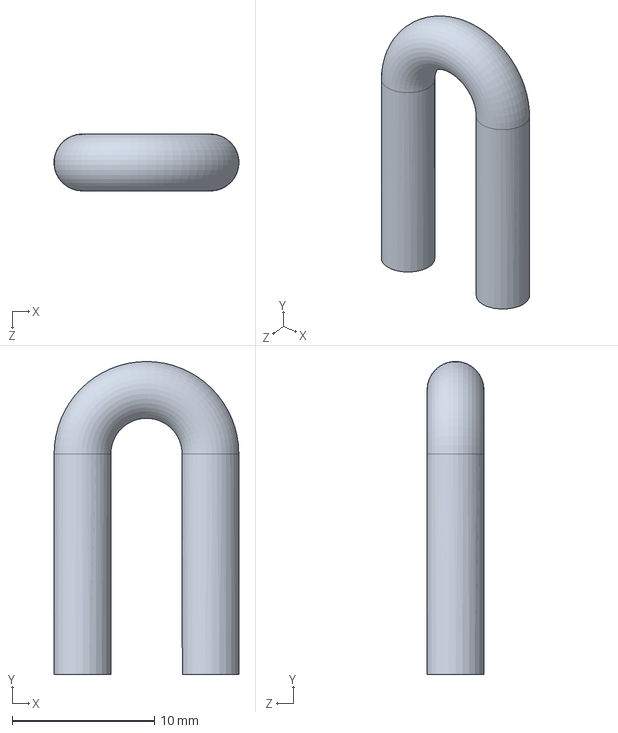
[picture p96: CAD file, 2020-11-12]
hardware/CAD/Modelo3D/Acoplamentos/Presilha Tipo-U/Presilha.SLDPRT
13.0 x 22.0 x 4.00 mm
