rafael-at97/WMRA-UnB/hardware/CAD/Modelo3D/Elos/Conector Nylon.SLDPRT

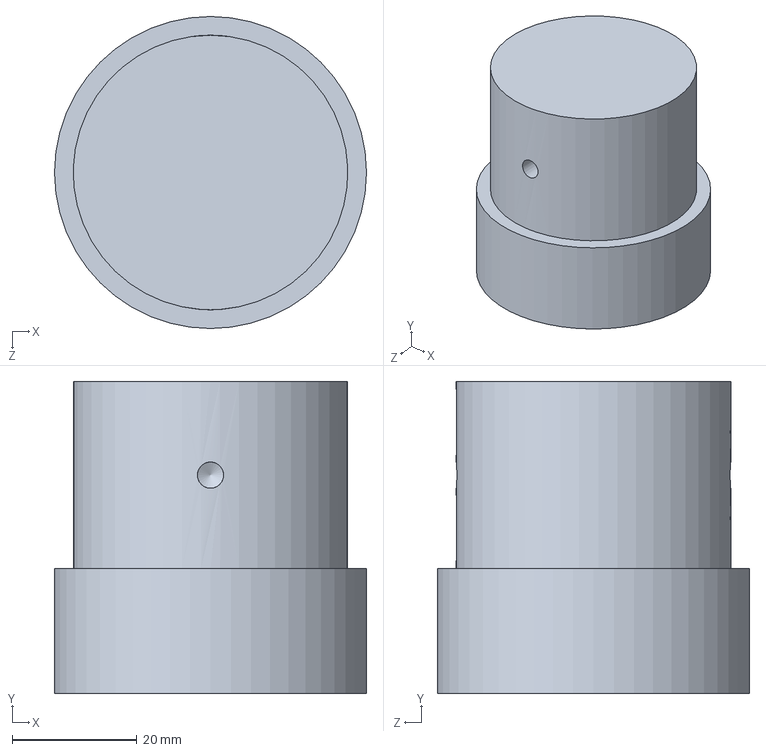
[picture p97: CAD file, 2020-04-07]
hardware/CAD/Modelo3D/Elos/Conector Nylon.SLDPRT
50.0 x 50.0 x 50.0 mm
