rafael-at97/WMRA-UnB/hardware/CAD/Modelo3D/Elos/Elo 1-2/Conector PVC 1-2.SLDPRT

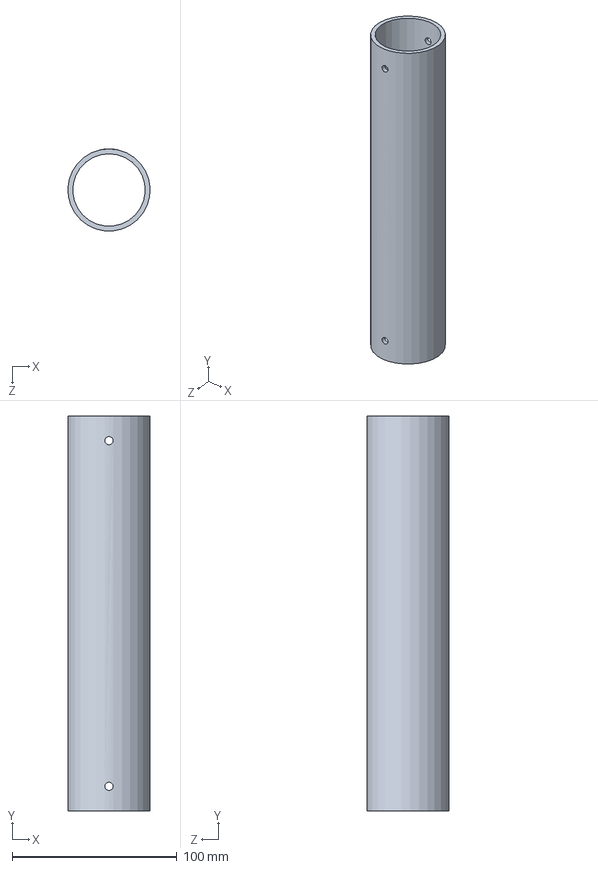
[picture p98: CAD file, 2020-04-07]
hardware/CAD/Modelo3D/Elos/Elo 1-2/Conector PVC 1-2.SLDPRT
49.9 x 240.0 x 50.0 mm
