rafael-at97/WMRA-UnB/hardware/CAD/Modelo3D/Junta 0/Junta 0 parte 2.SLDPRT

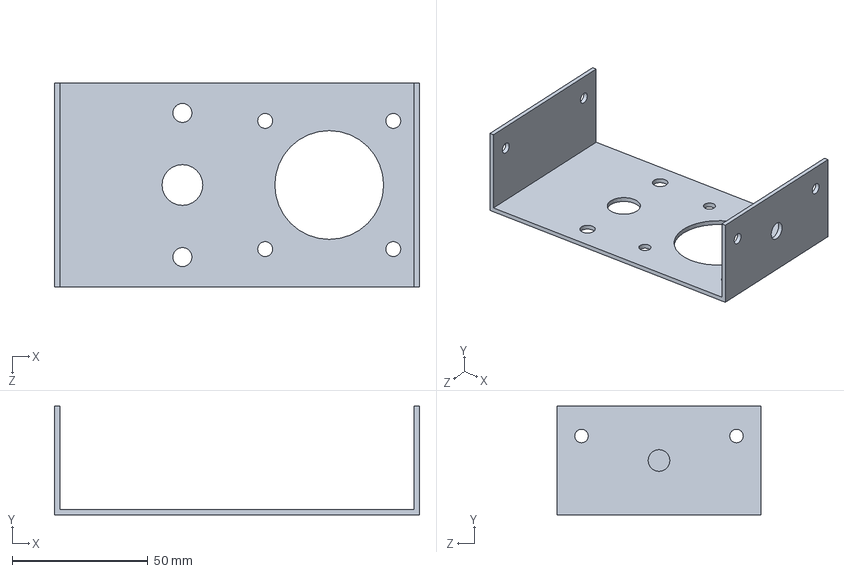
[picture p99: CAD file, 2020-04-07]
hardware/CAD/Modelo3D/Junta 0/Junta 0 parte 2.SLDPRT
134.2 x 40.0 x 75.0 mm
