rafael-at97/WMRA-UnB/hardware/CAD/Modelo3D/Junta 1/Eixo 1.SLDPRT

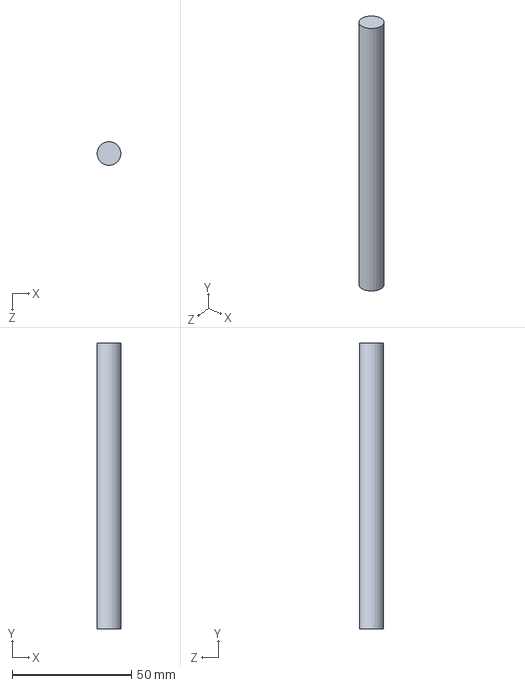
[picture p100: CAD file, 2020-04-07]
hardware/CAD/Modelo3D/Junta 1/Eixo 1.SLDPRT
10.0 x 120.0 x 10.0 mm
