rafael-at97/WMRA-UnB/hardware/CAD/Modelo3D/Junta 2-3/Junta 2-3 parte 3.SLDPRT

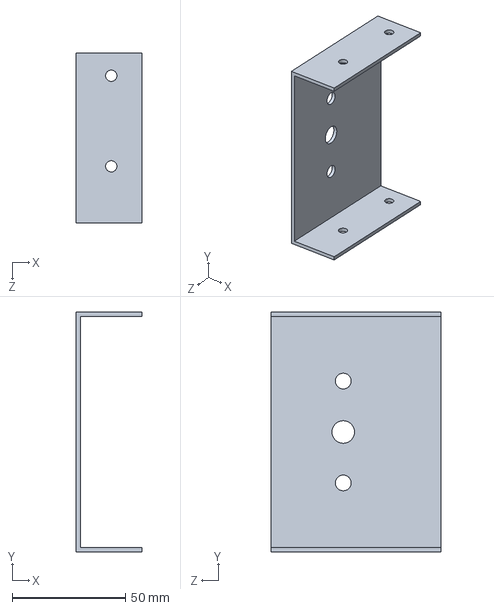
[picture p101: CAD file, 2020-04-07]
hardware/CAD/Modelo3D/Junta 2-3/Junta 2-3 parte 3.SLDPRT
29.0 x 106.0 x 75.0 mm
