rafael-at97/WMRA-UnB/hardware/CAD/Modelo3D/Junta 4/Junta 4 parte 1.SLDPRT

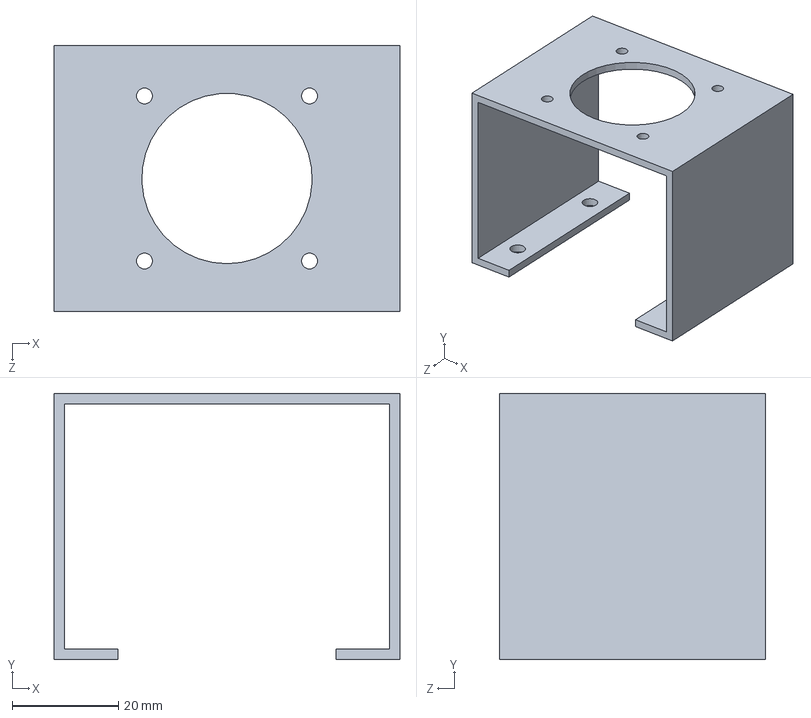
[picture p102: CAD file, 2020-04-07]
hardware/CAD/Modelo3D/Junta 4/Junta 4 parte 1.SLDPRT
65.0 x 50.0 x 50.0 mm
