rafael-at97/WMRA-UnB/hardware/CAD/Modelo3D/Junta 5/Junta 5.SLDPRT

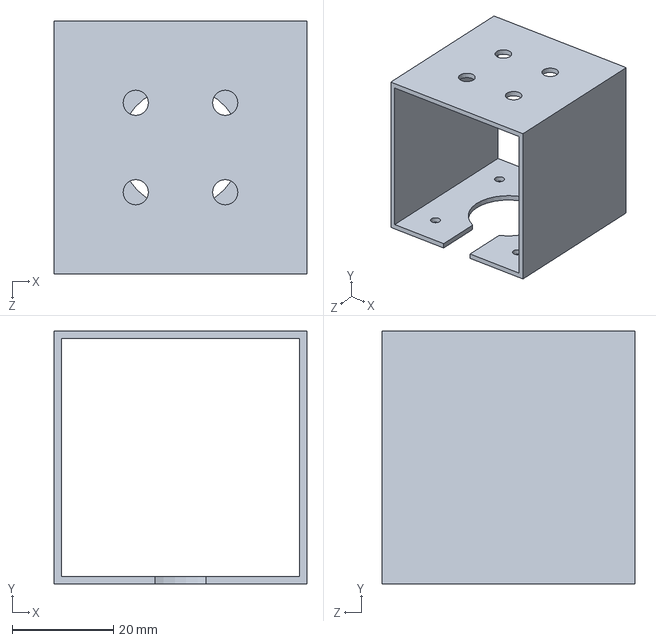
[picture p103: CAD file, 2020-04-07]
hardware/CAD/Modelo3D/Junta 5/Junta 5.SLDPRT
50.0 x 50.0 x 50.0 mm
