rafael-at97/WMRA-UnB/hardware/CAD/Modelo3D/Motores/NEMA17.SLDPRT

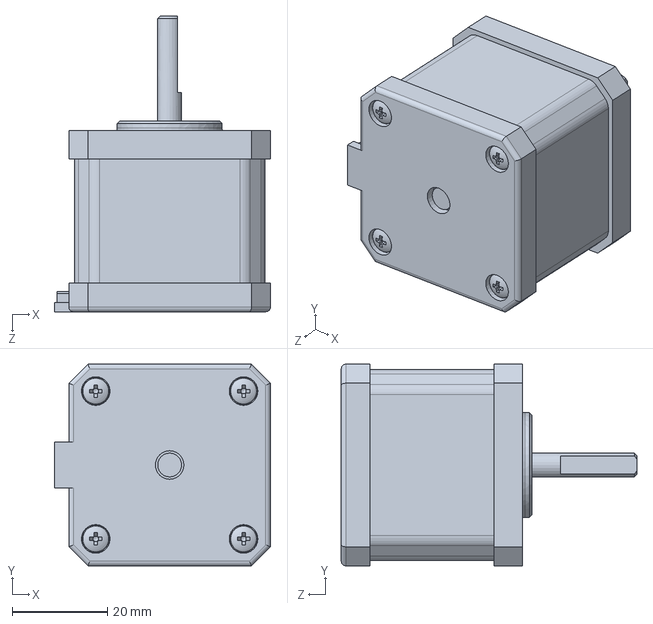
[picture p104: CAD file, 2020-04-07]
hardware/CAD/Modelo3D/Motores/NEMA17.SLDPRT
45.3 x 42.3 x 62.0 mm
