rafael-at97/WMRA-UnB/hardware/CAD/Modelo3D/Rolamentos/Rolamento KFL000 Ø10.SLDPRT

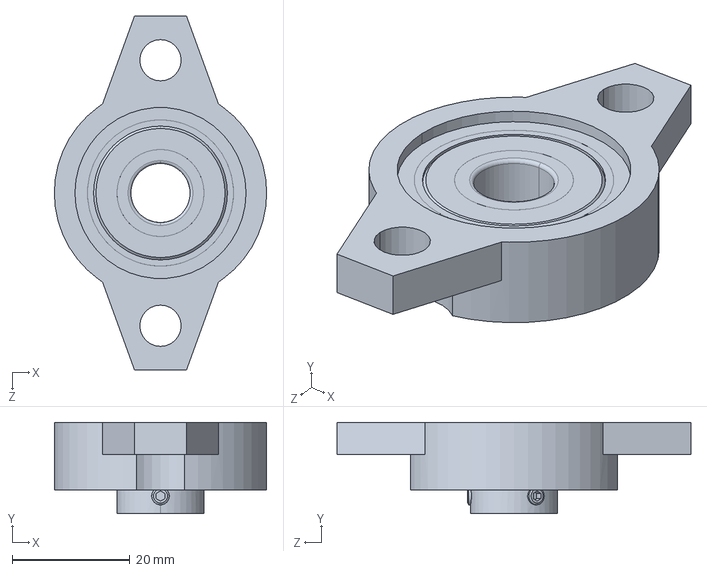
[picture p105: CAD file, 2020-04-07]
hardware/CAD/Modelo3D/Rolamentos/Rolamento KFL000 Ø10.SLDPRT
36.0 x 15.5 x 60.0 mm
