rafael-at97/WMRA-UnB/hardware/CAD/Modelo3D/Sensores/Potentiometer-Gear.SLDPRT

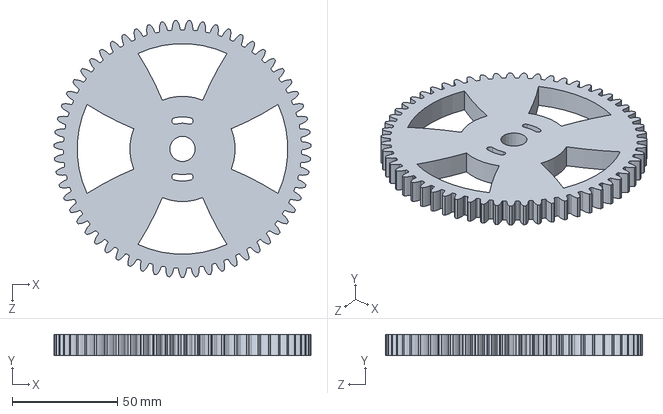
[picture p106: CAD file, 2020-11-12]
hardware/CAD/Modelo3D/Sensores/Potentiometer-Gear.SLDPRT
122.0 x 10.0 x 121.9 mm
