rafael-at97/WMRA-UnB/hardware/CAD/Modelo3D/Elos/Caixa Aluminio 1.SLDPRT

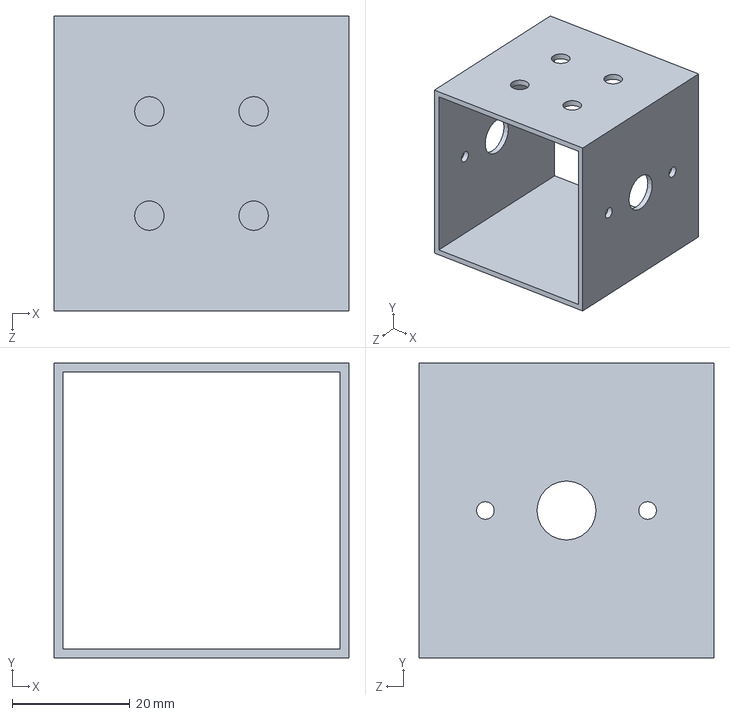
[picture p107: CAD file, 2020-04-07]
hardware/CAD/Modelo3D/Elos/Caixa Aluminio 1.SLDPRT
50.0 x 50.0 x 50.0 mm
