rafael-at97/WMRA-UnB/hardware/CAD/Modelo3D/Junta 0/Junta 0 parte 3.SLDPRT

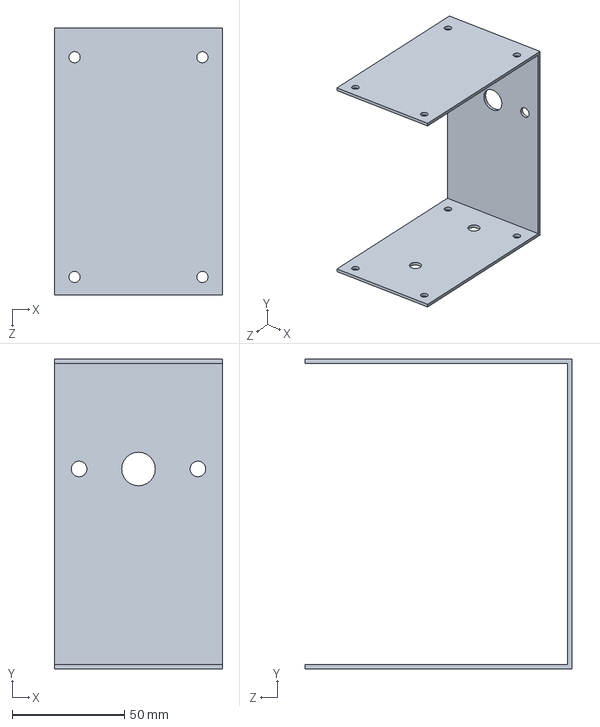
[picture p108: CAD file, 2020-04-07]
hardware/CAD/Modelo3D/Junta 0/Junta 0 parte 3.SLDPRT
75.0 x 138.2 x 119.0 mm
