rafael-at97/WMRA-UnB/hardware/CAD/Modelo3D/Junta 1/Junta 1 parte 1.SLDPRT

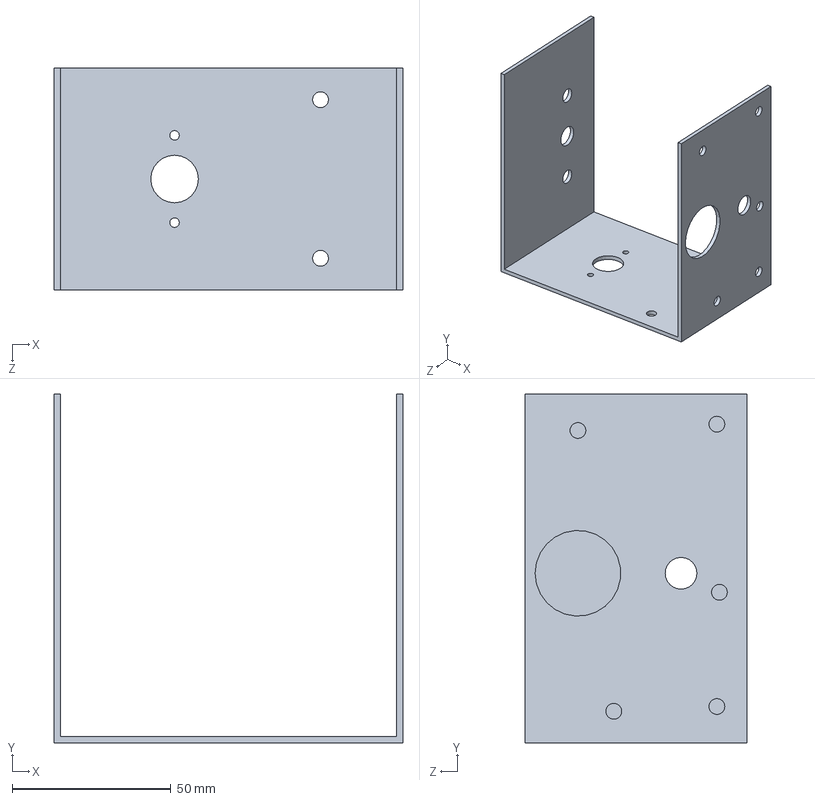
[picture p109: CAD file, 2020-04-07]
hardware/CAD/Modelo3D/Junta 1/Junta 1 parte 1.SLDPRT
110.0 x 110.0 x 70.0 mm
