rafael-at97/WMRA-UnB/hardware/CAD/Modelo3D/Junta 2-3/Junta 2-3 parte 1.SLDPRT

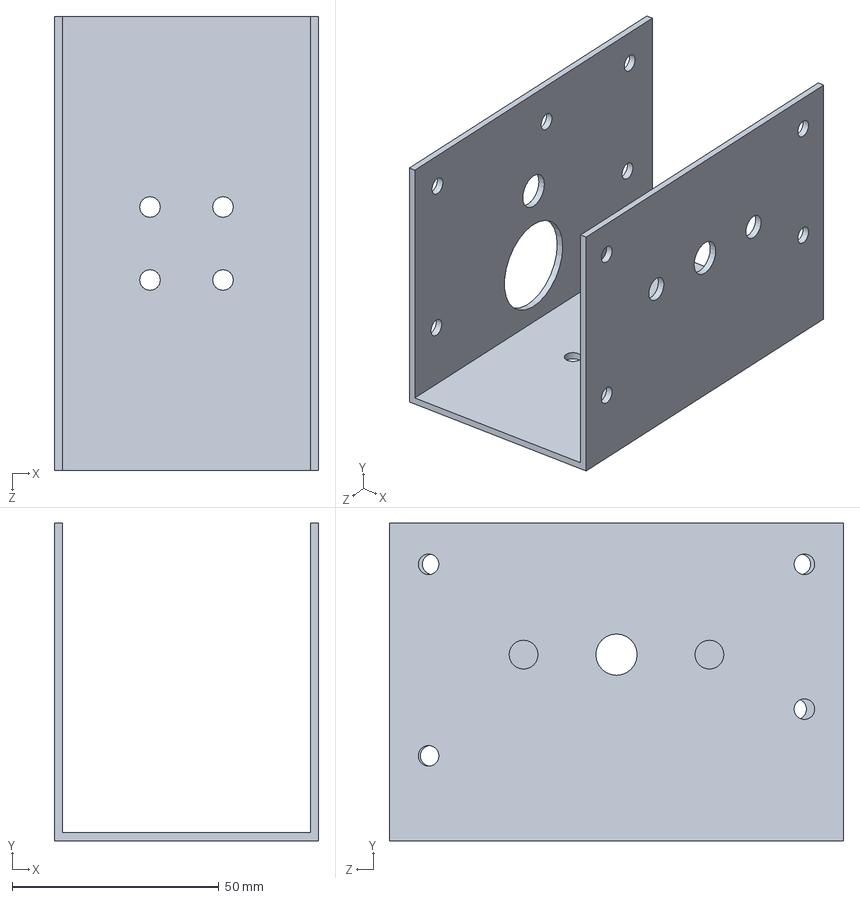
[picture p110: CAD file, 2020-04-07]
hardware/CAD/Modelo3D/Junta 2-3/Junta 2-3 parte 1.SLDPRT
64.0 x 77.0 x 110.0 mm
