rafael-at97/WMRA-UnB/hardware/CAD/Modelo3D/Junta 4/Junta 4 parte 2.SLDPRT

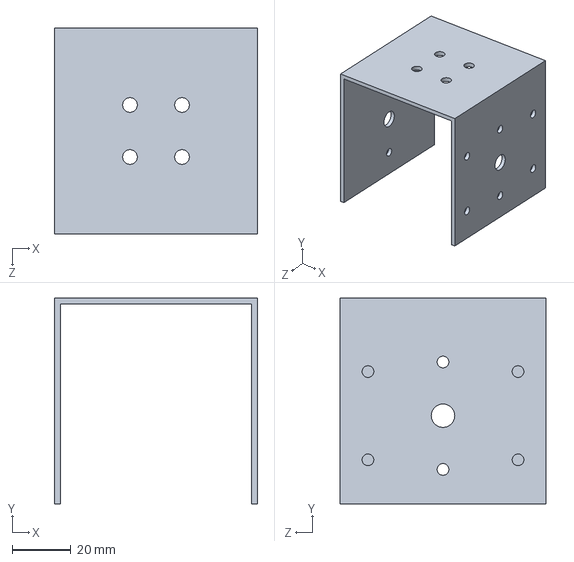
[picture p111: CAD file, 2020-04-07]
hardware/CAD/Modelo3D/Junta 4/Junta 4 parte 2.SLDPRT
69.0 x 70.0 x 70.0 mm
