rafael-at97/WMRA-UnB/hardware/CAD/Modelo3D/Motores/NEMA23.SLDPRT

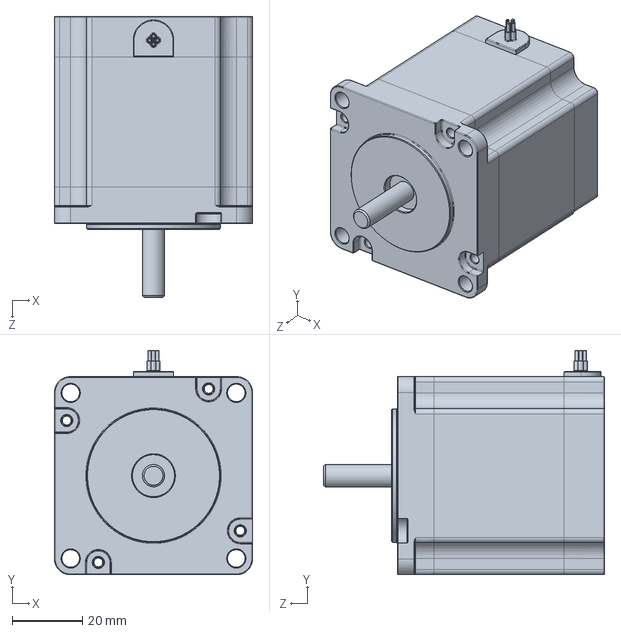
[picture p112: CAD file, 2020-04-07]
hardware/CAD/Modelo3D/Motores/NEMA23.SLDPRT
56.4 x 63.9 x 80.0 mm
