rafael-at97/WMRA-UnB/hardware/CAD/Modelo3D/Rolamentos/Rolamento KFL002 Ø15.SLDPRT

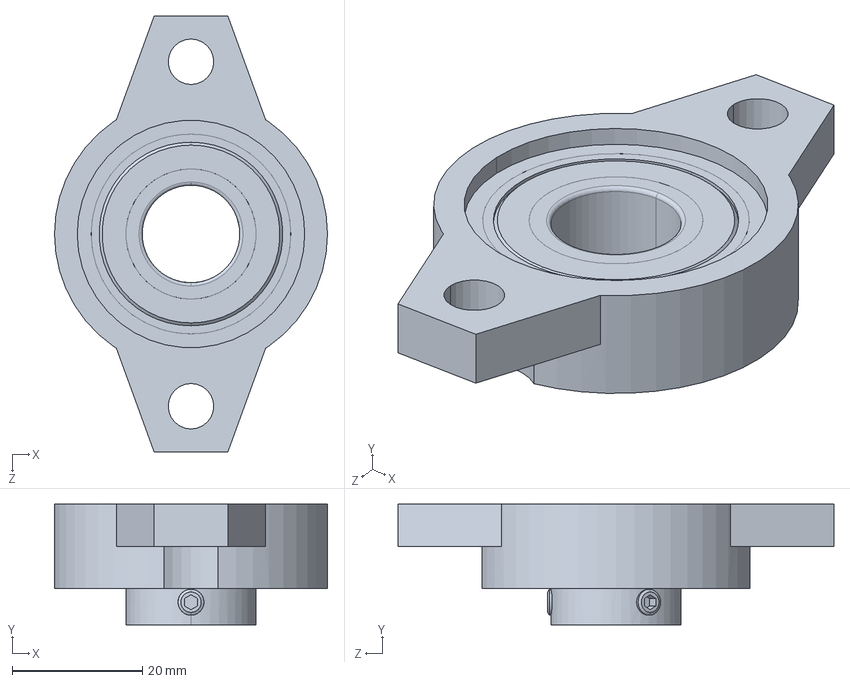
[picture p113: CAD file, 2020-04-07]
hardware/CAD/Modelo3D/Rolamentos/Rolamento KFL002 Ø15.SLDPRT
42.0 x 18.6 x 67.0 mm
