rafael-at97/WMRA-UnB/hardware/CAD/Modelo3D/Sensores/Bourns-Potentiometer.SLDPRT

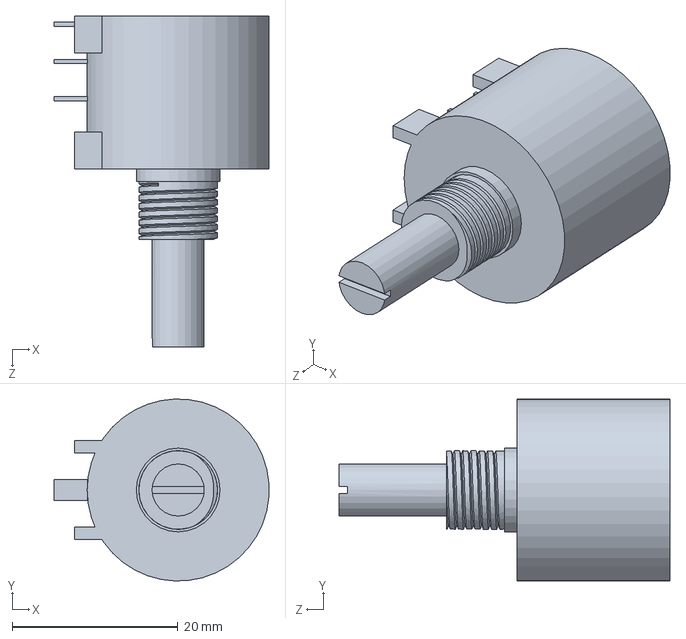
[picture p114: CAD file, 2020-11-12]
hardware/CAD/Modelo3D/Sensores/Bourns-Potentiometer.SLDPRT
26.0 x 22.0 x 40.0 mm
