rafael-at97/WMRA-UnB/hardware/CAD/Modelo3D/Junta 0/Eixo 0.SLDPRT

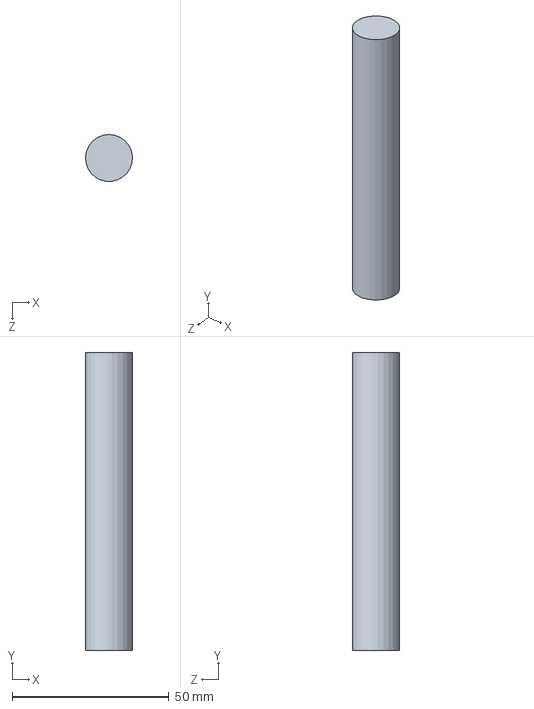
[picture p115: CAD file, 2020-04-07]
hardware/CAD/Modelo3D/Junta 0/Eixo 0.SLDPRT
15.0 x 95.0 x 15.0 mm
