rafael-at97/WMRA-UnB/hardware/CAD/Modelo3D/Junta 2-3/Eixo 2-3.SLDPRT

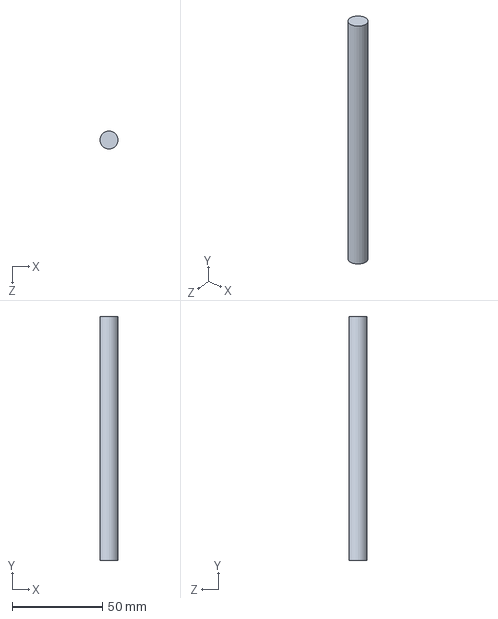
[picture p116: CAD file, 2020-04-07]
hardware/CAD/Modelo3D/Junta 2-3/Eixo 2-3.SLDPRT
10.0 x 135.0 x 10.0 mm
