rafael-at97/WMRA-UnB/hardware/CAD/Modelo3D/Motores/Motor Mabuchi LD.SLDPRT

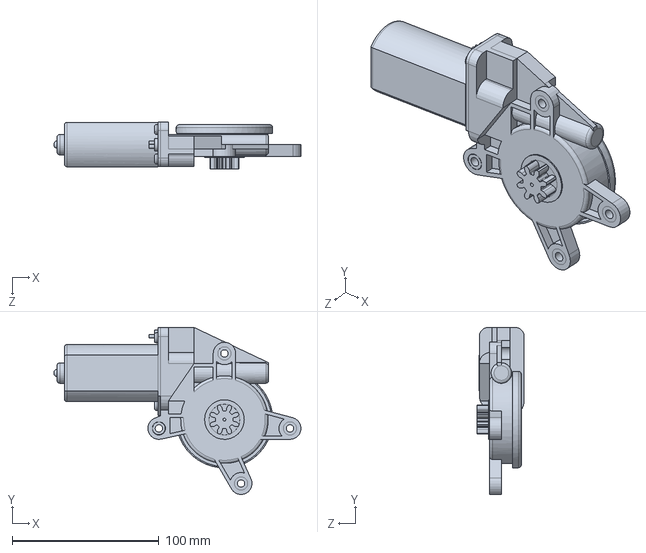
[picture p117: CAD file, 2020-04-07]
hardware/CAD/Modelo3D/Motores/Motor Mabuchi LD.SLDPRT
168.1 x 113.7 x 32.2 mm
