rafael-at97/WMRA-UnB/hardware/CAD/Modelo3D/Sensores/Potentiometer-InternalGear.SLDPRT

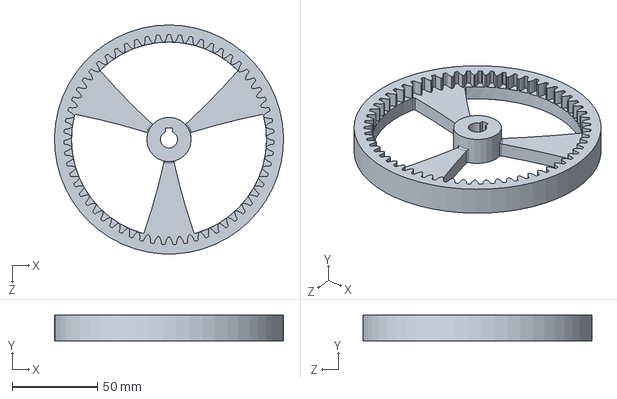
[picture p118: CAD file, 2020-11-12]
hardware/CAD/Modelo3D/Sensores/Potentiometer-InternalGear.SLDPRT
133.9 x 15.0 x 134.0 mm
