rafael-at97/WMRA-UnB/hardware/CAD/Modelo3D/Junta 2-3/Junta 2-3 parte 4.SLDPRT

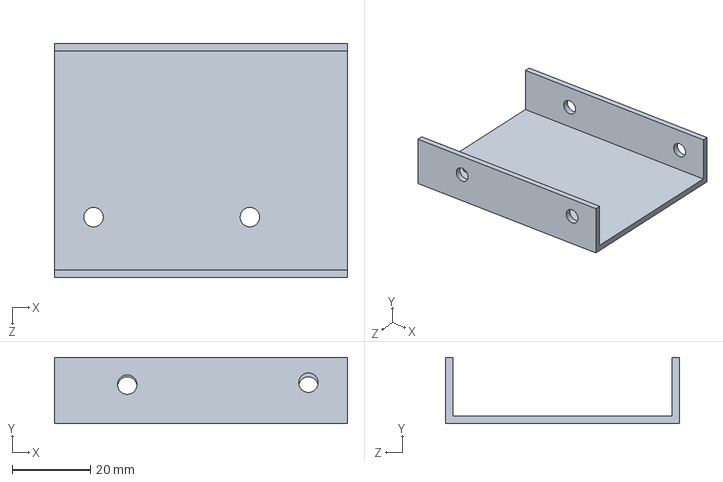
[picture p119: CAD file, 2020-04-07]
hardware/CAD/Modelo3D/Junta 2-3/Junta 2-3 parte 4.SLDPRT
75.0 x 17.0 x 60.0 mm
