rafael-at97/WMRA-UnB/(list of files, cad)

Other CAD files:
hardware/CAD/Modelo3D/Elos/Elo 3-4/Elo3-Assembly.SLDASM
hardware/CAD/Modelo3D/Buchas/Bucha 15 mm.SLDPRT
hardware/CAD/Modelo3D/Buchas/Bucha 10 mm.SLDPRT
hardware/CAD/Modelo3D/Junta 2-3/Junta 2-3 parte 2.SLDPRT
