rafael-at97/WMRA-UnB/hardware/MainPCB/Project Outputs for MainPCB/Schematic+Board.PDF

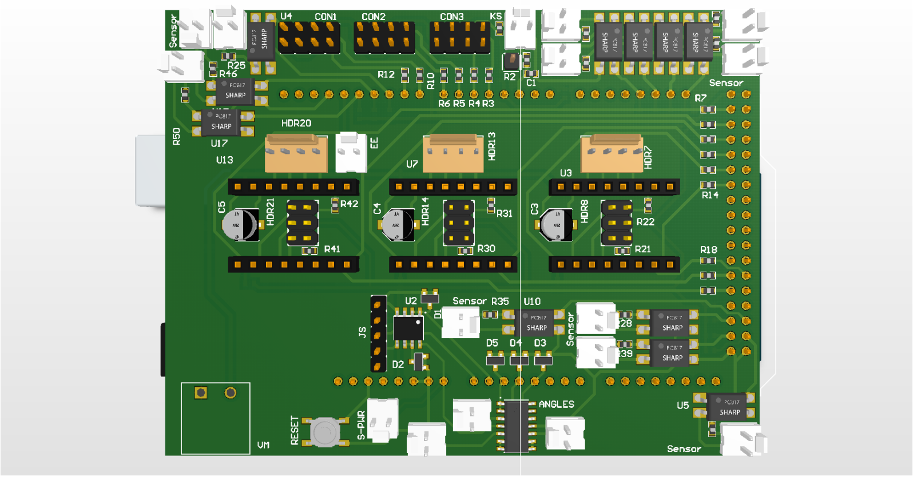
[picture p140: page 1]

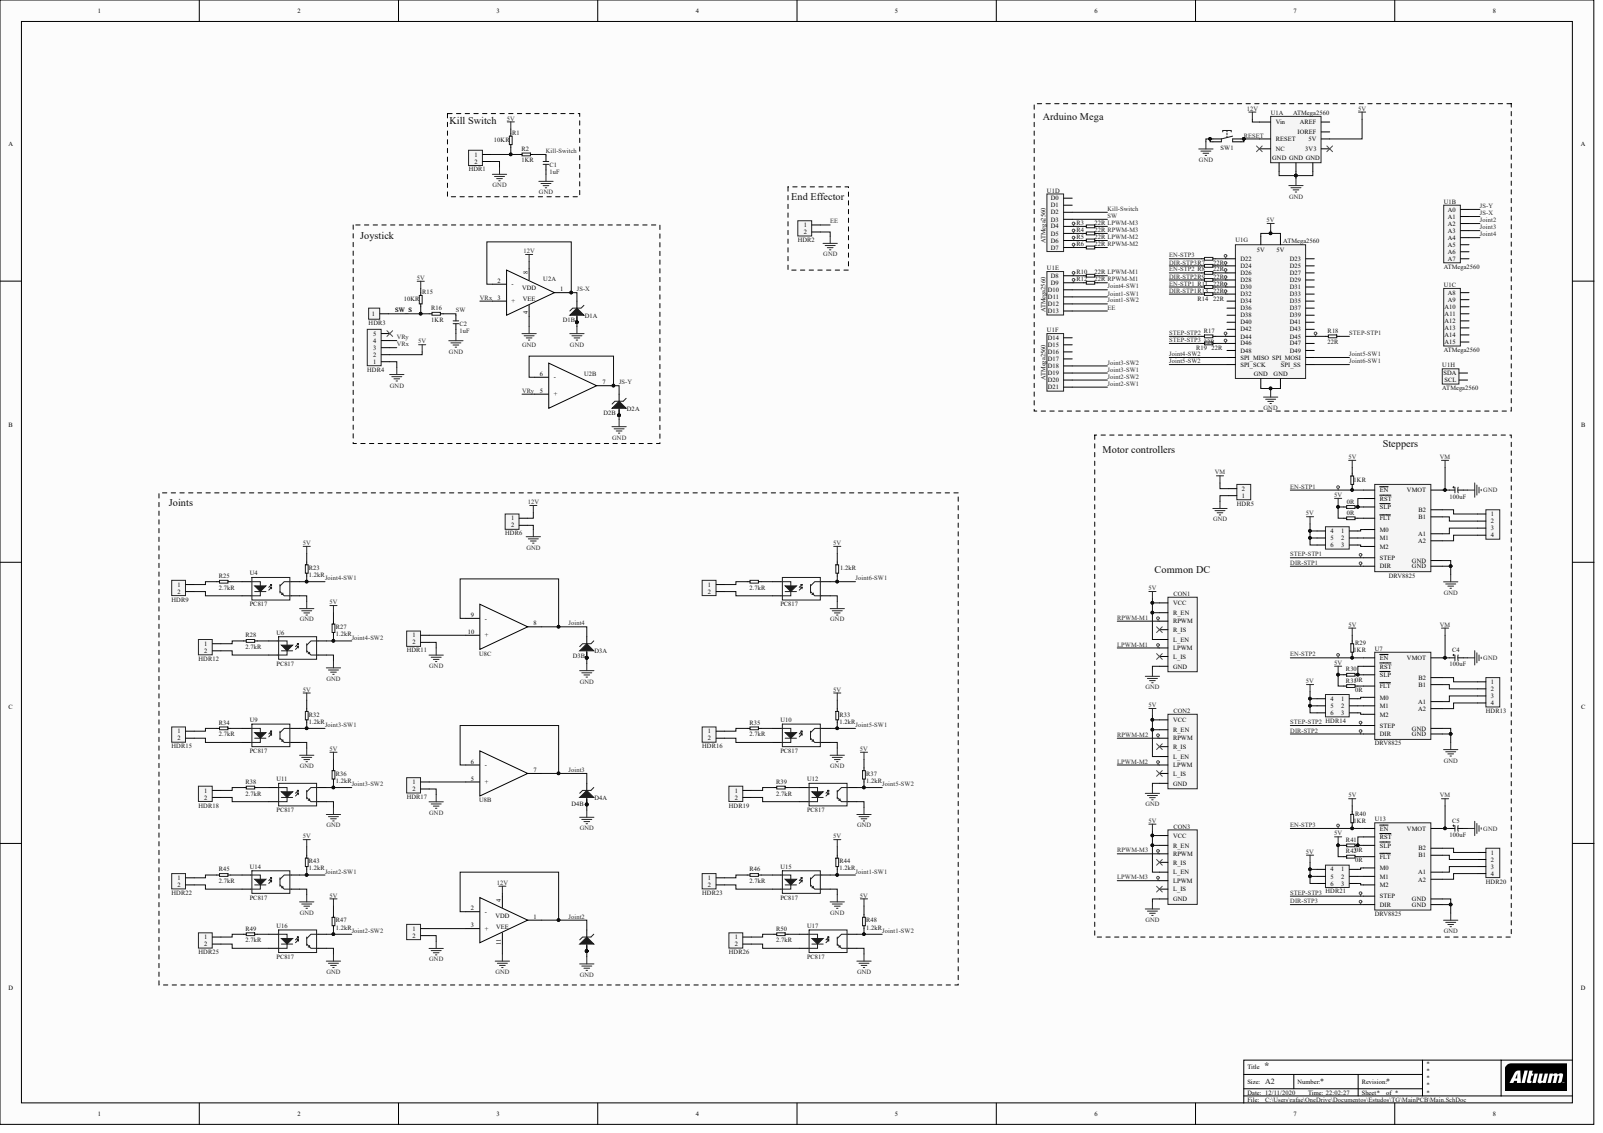
[picture p141: page 3]

Size: A 2 | N umber: * | Rev i s i o n : *
Date: 1 2 / 1 1 / 2 0 2 0 T ime: 2 2 : 0 2 : 2 7 | | Sheet * o f *
Fi le: C: \ U sers \rafae\ O neDri ve\ D ocumen t o s \ E s t u d o s \ T G \Mai nPCB\Mai n.Sch D o c
