rafael-at97/WMRA-UnB/hardware/FeedbackPCB/Project Outputs for FeedbackPCB/Schematic+Board.PDF

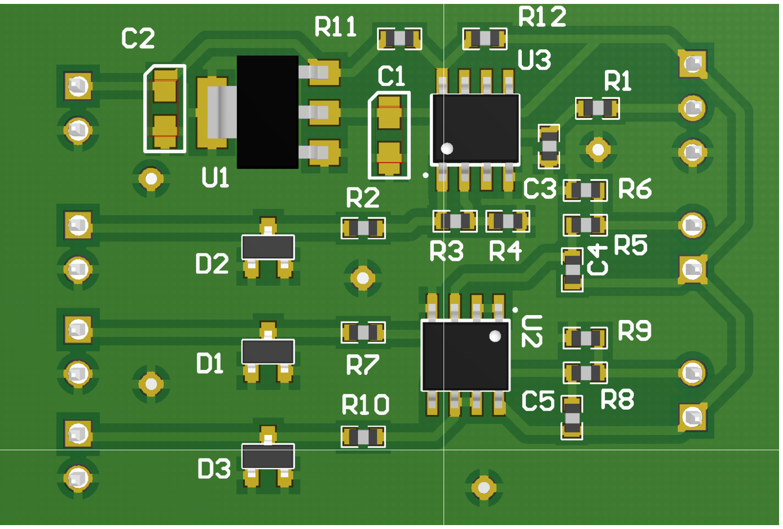
[picture p142: page 1]

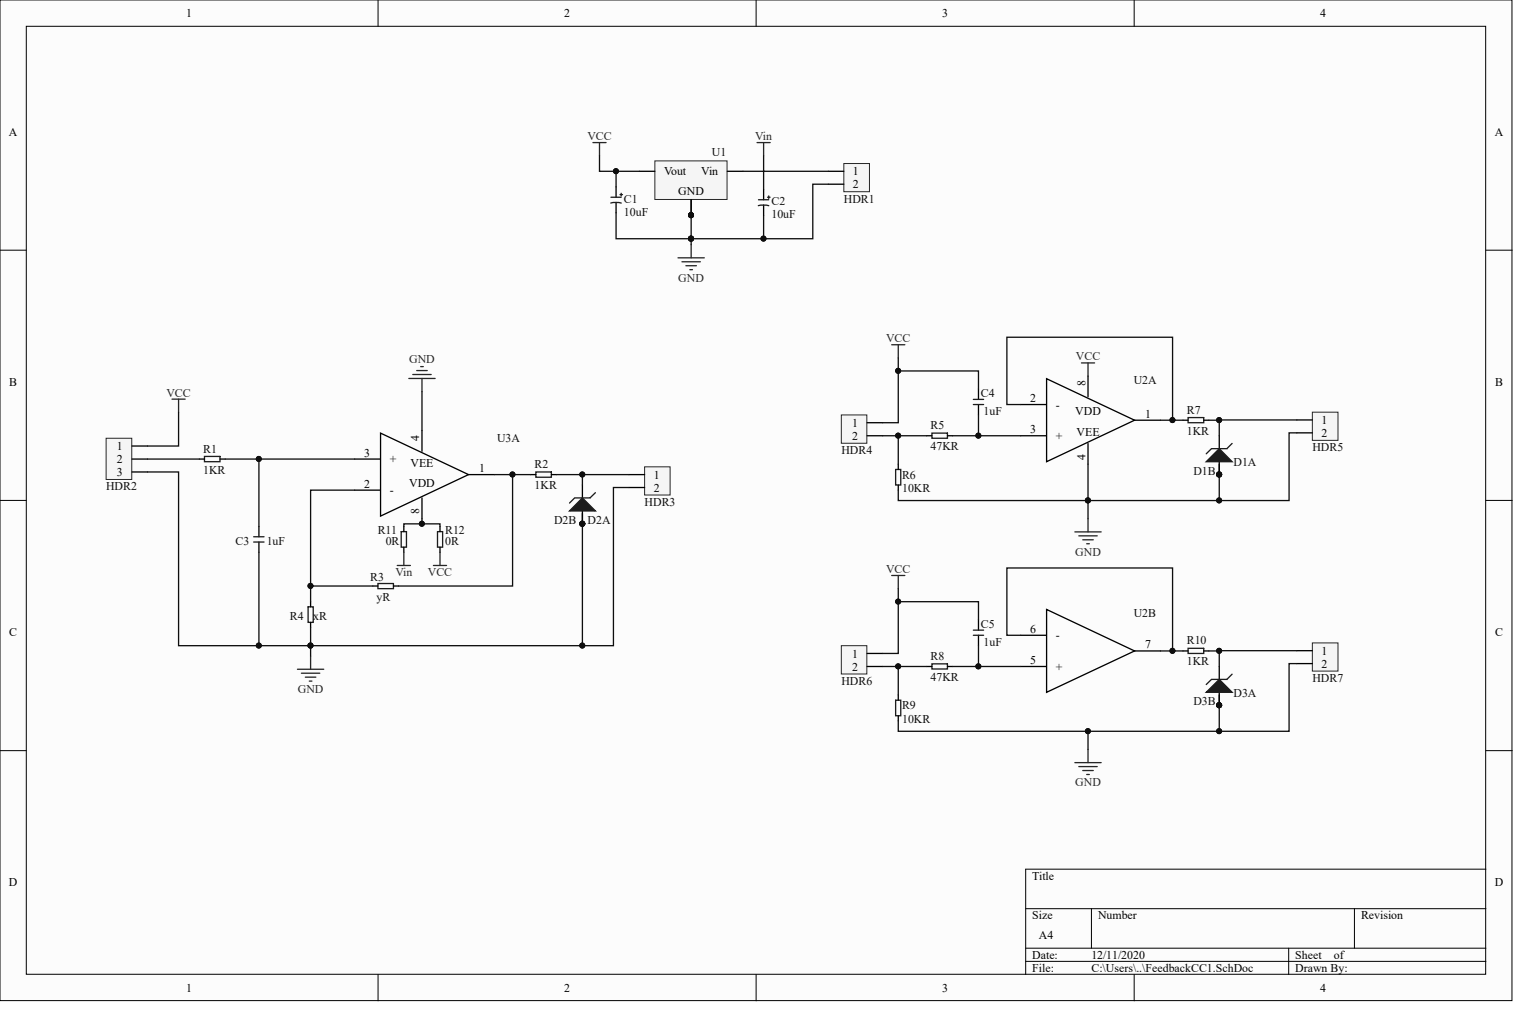
[picture p143: page 2]

Size A4 | Number | Revision

Date: 12/11/2020 | Sheet of
File: C:\Users\..\FeedbackCC1.SchDoc | Drawn By:
