rafael-at97/WMRA-UnB/(list of files, drawings)

Other design files:
hardware/Altium-common/TG-Lib.SchLib
hardware/FeedbackPCB/FeedbackCC1.PcbDoc
hardware/FeedbackPCB/FeedbackCC1.SchDoc
hardware/FeedbackPCB/FeedbackCC2.PcbDoc
hardware/FeedbackPCB/FeedbackPCB.PrjPcb
hardware/MainPCB/Main.SchDoc
hardware/MainPCB/MainPCB.PrjPcb
