rafael-at97/WMRA-UnB/(commit log)

2020-04-05 Inital torque analysis
2020-04-07 Hardware organization
    CAD files
    [Acoplamento Flexível MSTS-16-5-8.SLDPRT, Assembly Geral.SLDASM, Bucha 10 mm.SLDPRT, Bucha 15 mm.SLDPRT, Bucha 8 mm.SLDPRT, Caixa Aluminio 1.SLDPRT, Caixa Alumínio 2.SLDASM, Caixa Alumínio.SLDASM]
2020-04-29 Inclusion of spring calculations and Arduino joystick codes
2020-08-04 Initial code for robotic arm control
2020-09-28 Working plotter and arduino interface
2020-11-12 Stepper motor actuation working
2020-11-12 CAD - Presilha U
    [Presilha-Assembly.SLDASM, Presilha.SLDPRT, PresilhaHousing.SLDPRT]
2020-11-12 Molas, Parafusos, Sensores e Assembly geral atualizado
    [Assembly Geral.SLDASM, Bourns-Potentiometer.SLDPRT, Mola-tracao.SLDPRT, Parafuso-mola.SLDPRT, Potentiometer-Gear.SLDPRT, Potentiometer-InternalGear.SLDPRT, Potentiometer-Knob.SLDPRT]
2020-11-12 FeedbackPCB files
    [FeedbackCC1.PcbDoc, FeedbackCC1.SchDoc, FeedbackCC2.PcbDoc, FeedbackPCB.PrjPcb]
2020-11-12 MainPCB project files
    [Main.SchDoc, MainPCB.PrjPcb]
2020-11-12 Altium libraries
    [TG-Lib.SchLib]
2020-11-12 Fixing commits made directly through github
    [FeedbackCC1.PcbDoc, FeedbackCC1.SchDoc, FeedbackCC2.PcbDoc, FeedbackPCB.PrjPcb]
